Bcvdkerc/VOP-Social-Robot/README.md

# VOP-Social-Robot
All the files necessairy to build a social robot. (Laser cutting + 3d-printing)
