Bcvdkerc/VOP-Social-Robot/sldprt/ONO-modules/Mouth/mouth.sldasm

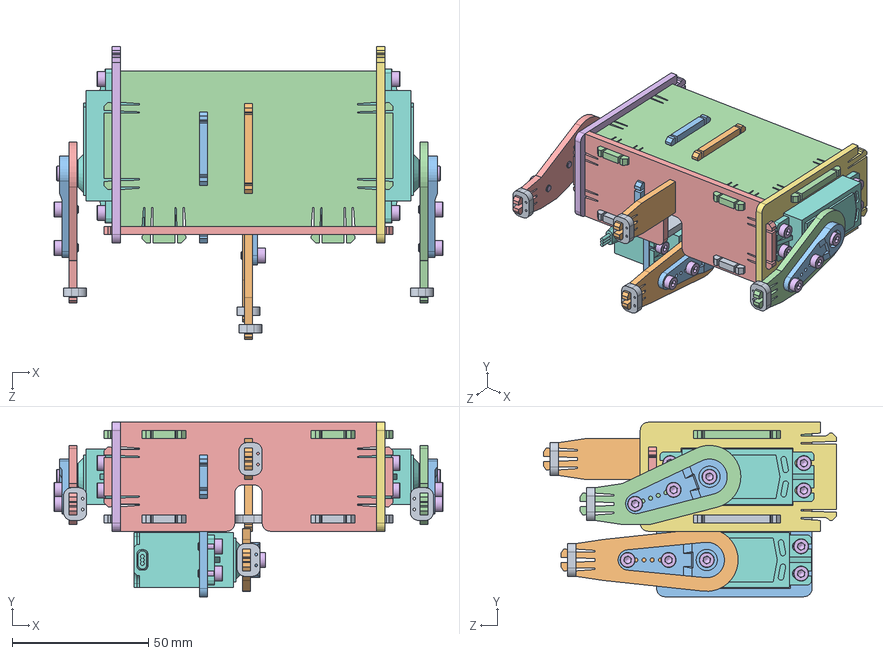
[picture p1: CAD file, 2017-05-16]
sldprt/ONO-modules/Mouth/mouth.sldasm
142.6 x 64.0 x 107.5 mm
mouth-frame-1
mouth-frame-2
mouth-frame-3
mouth-frame-4
mouth-frame-5
mouth-frame-6
mouth-frame-7
servo-standard x 3
textile-snap x 4
lever-mid-towerpro-horn
servo-horn-towerpro-1-arm x 3
lever-outer-l-towerpro-horn
lever-outer-r-towerpro-horn
socket head cap screw_iso x 21
