Bcvdkerc/VOP-Social-Robot/sldprt/ONO-modules/Eyebrow/eyebrow.sldasm

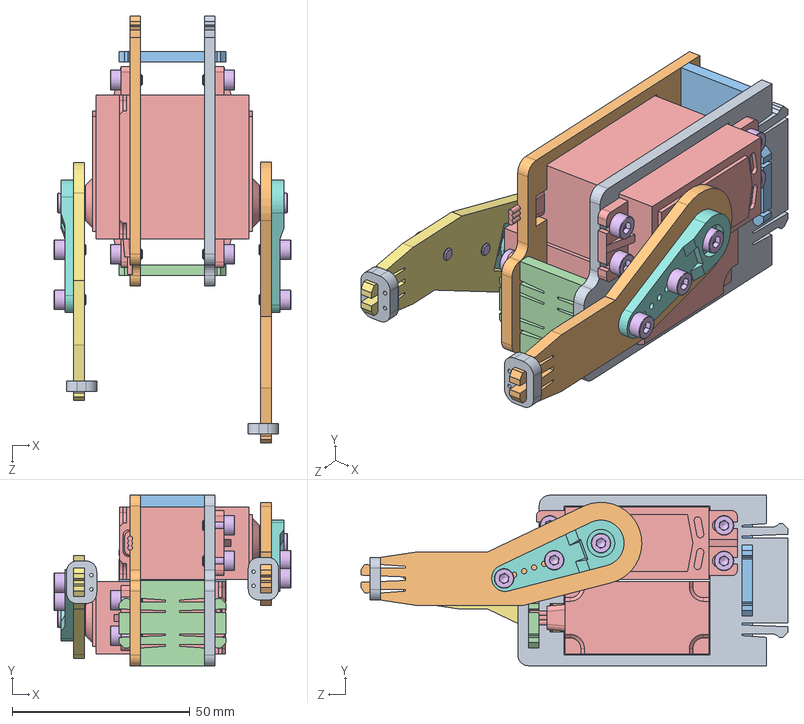
[picture p2: CAD file, 2017-05-16]
sldprt/ONO-modules/Eyebrow/eyebrow.sldasm
66.6 x 48.0 x 120.1 mm
eyebrow-frame-1
eyebrow-frame-2
eyebrow-frame-3
eyebrow-frame-4
servo-standard x 2
socket head cap screw_iso x 14
lever-outer-towerpro-horn
servo-horn-towerpro-1-arm x 2
textile-snap x 2
lever-inner-towerpro-horn
