Bcvdkerc/VOP-Social-Robot/3d-printing/pivot-beam-r.STL

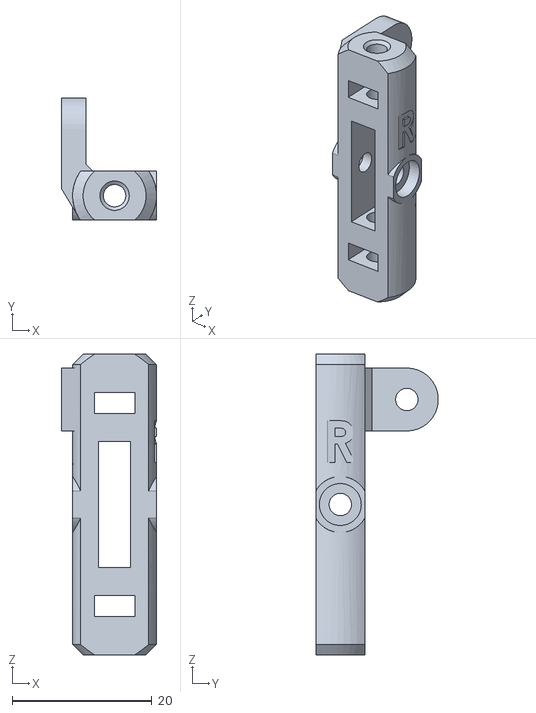
[picture p4: CAD file, 2017-05-16]
3d-printing/pivot-beam-r.STL
13.6 x 17.5 x 43.0
