Bcvdkerc/VOP-Social-Robot/dxf_lasercut/Arms/arms_laser.dxf

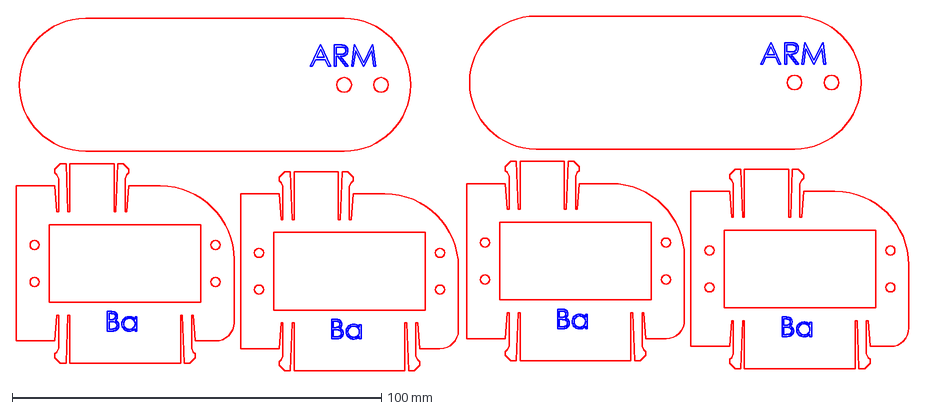
[picture p5: CAD file, 2017-05-16]
dxf_lasercut/Arms/arms_laser.dxf
241.7 x 96.1 mm
