Bcvdkerc/VOP-Social-Robot/dxf_lasercut/Body/b3.DXF

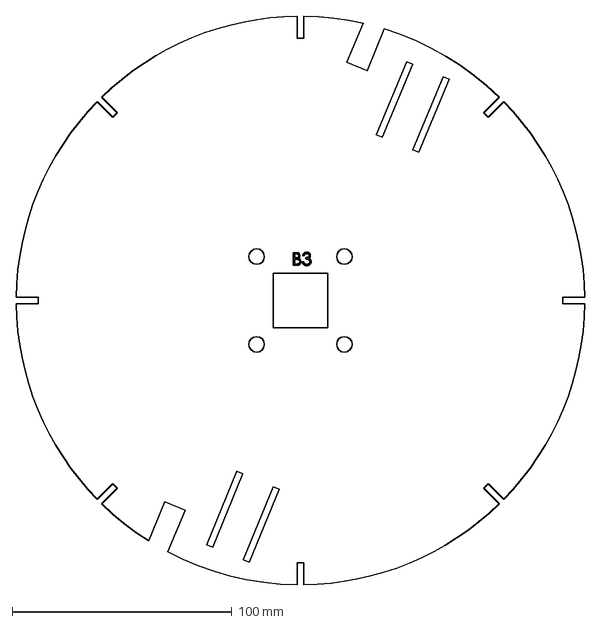
[picture p6: CAD file, 2017-05-16]
dxf_lasercut/Body/b3.DXF
258.8 x 258.8 mm
