Bcvdkerc/VOP-Social-Robot/dxf_lasercut/Box/BOXZ1.DXF

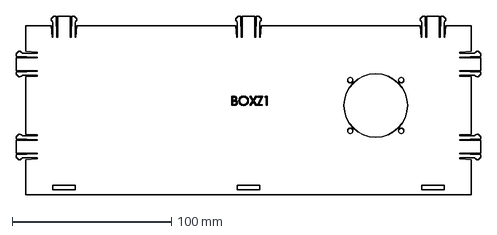
[picture p7: CAD file, 2017-05-16]
dxf_lasercut/Box/BOXZ1.DXF
292.0 x 112.0 mm
