Bcvdkerc/VOP-Social-Robot/dxf_lasercut/Head/HY3a.dxf

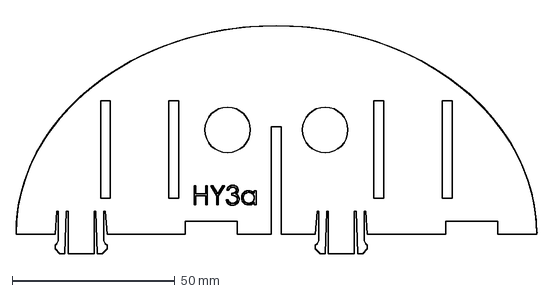
[picture p8: CAD file, 2017-05-16]
dxf_lasercut/Head/HY3a.dxf
160.1 x 72.9 mm
