Bcvdkerc/VOP-Social-Robot/dxf_lasercut/Neck/neck.DXF

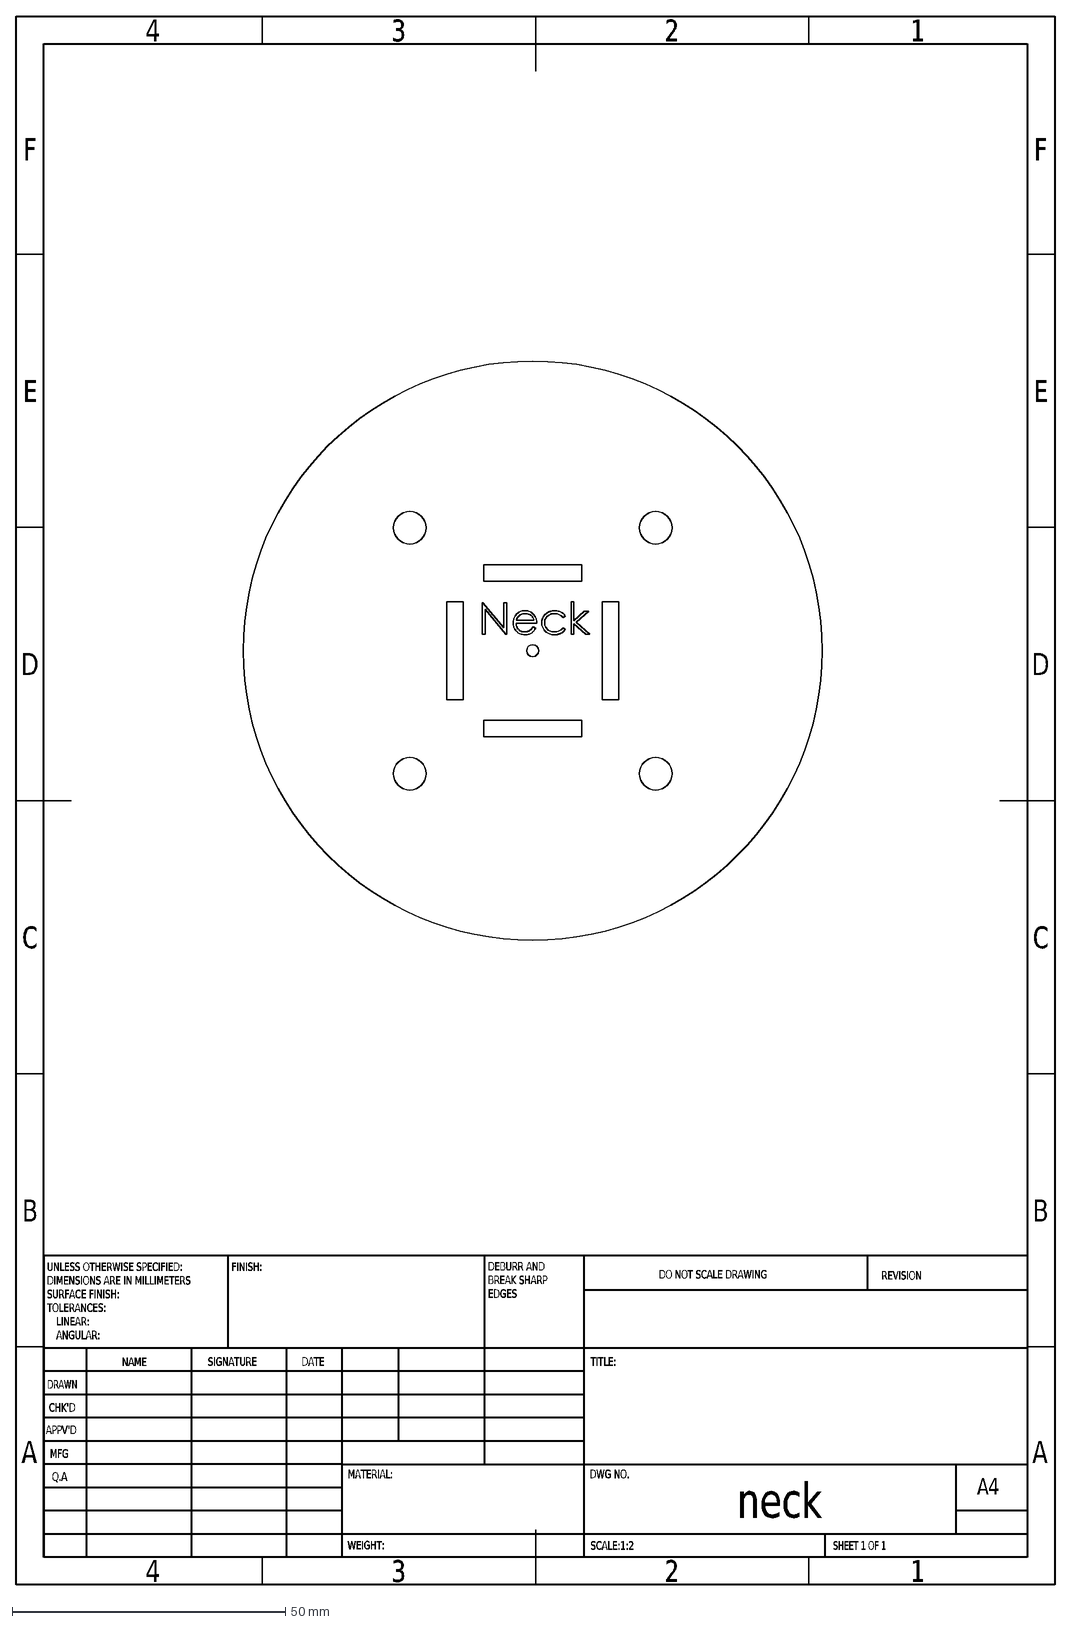
[picture p9: CAD file, 2017-05-16]
dxf_lasercut/Neck/neck.DXF
A
B
C
D
E
F
4
3
2
1
DRAWN
CHK'D
APPV'D
MFG
Q.A
UNLESS OTHERWISE SPECIFIED:
DIMENSIONS ARE IN MILLIMETERS
SURFACE FINISH:
TOLERANCES:
LINEAR:
ANGULAR:
FINISH:
DEBURR AND
BREAK SHARP
EDGES
NAME
SIGNATURE
DATE
MATERIAL:
DO NOT SCALE DRAWING
REVISION
TITLE:
DWG NO.
SCALE:1:2
SHEET 1 OF 1
A4
WEIGHT:
neck
