Bcvdkerc/VOP-Social-Robot/dxf_lasercut/ONO-modules/Eye/eye-laser.dxf

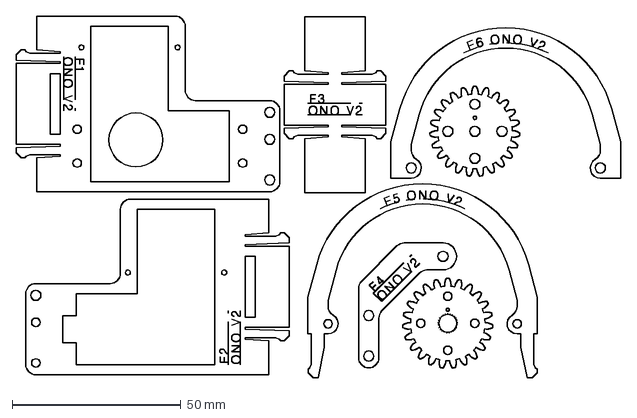
[picture p10: CAD file, 2017-05-16]
dxf_lasercut/ONO-modules/Eye/eye-laser.dxf
178.9 x 107.1 mm
