Bcvdkerc/VOP-Social-Robot/dxf_lasercut/ONO-modules/Eyebrow/eyebrow-laser.dxf

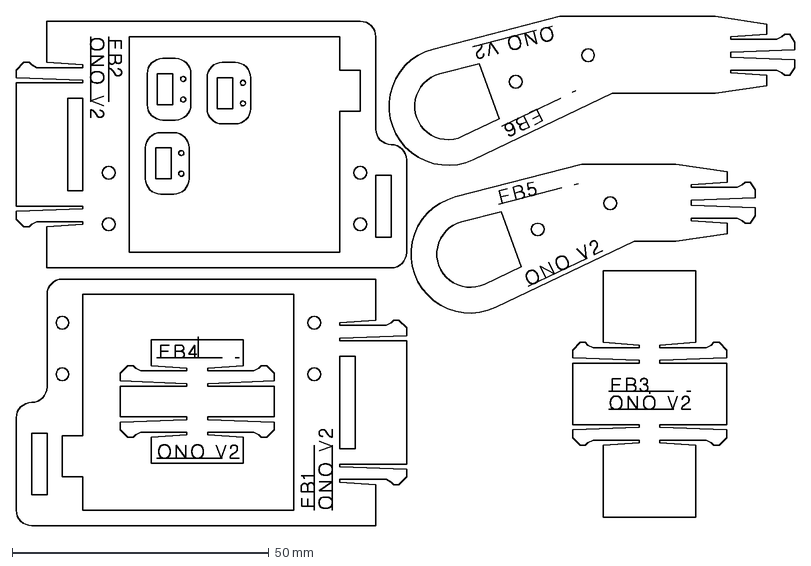
[picture p11: CAD file, 2017-05-16]
dxf_lasercut/ONO-modules/Eyebrow/eyebrow-laser.dxf
151.6 x 99.1 mm
