Bcvdkerc/VOP-Social-Robot/dxf_lasercut/ONO-modules/Mouth/mouth-laser.dxf

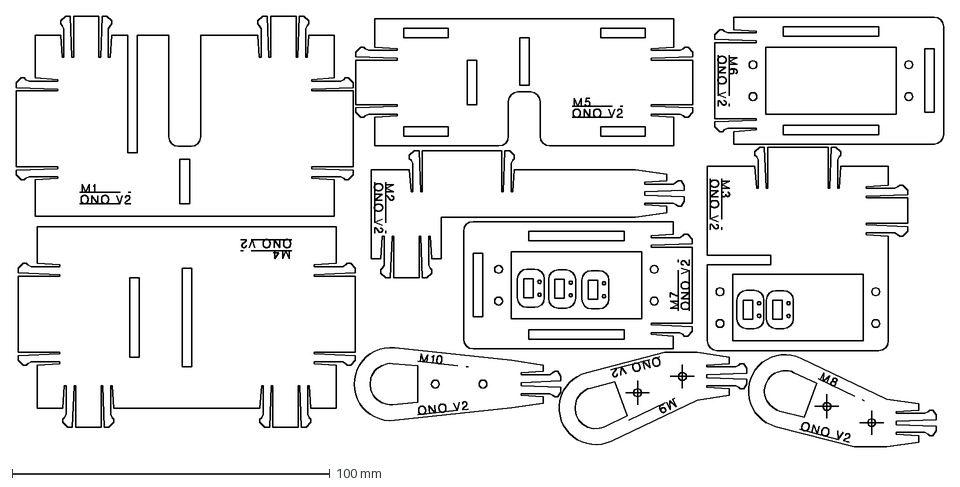
[picture p12: CAD file, 2017-05-16]
dxf_lasercut/ONO-modules/Mouth/mouth-laser.dxf
291.8 x 135.6 mm
