Bcvdkerc/VOP-Social-Robot/sldprt/Arms/Ba.SLDPRT

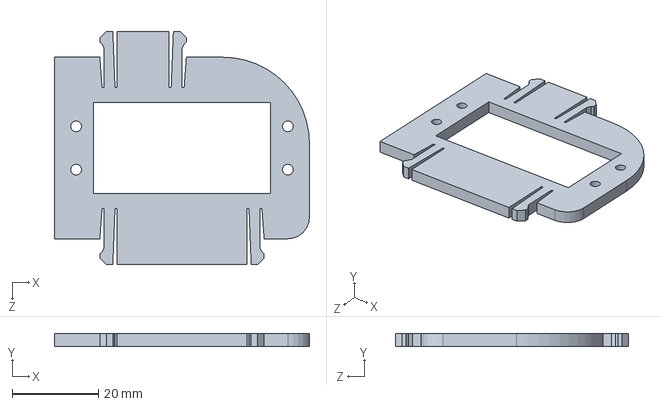
[picture p13: CAD file, 2017-05-16]
sldprt/Arms/Ba.SLDPRT
59.0 x 3.00 x 54.0 mm
