Bcvdkerc/VOP-Social-Robot/sldprt/Body/b2.SLDPRT

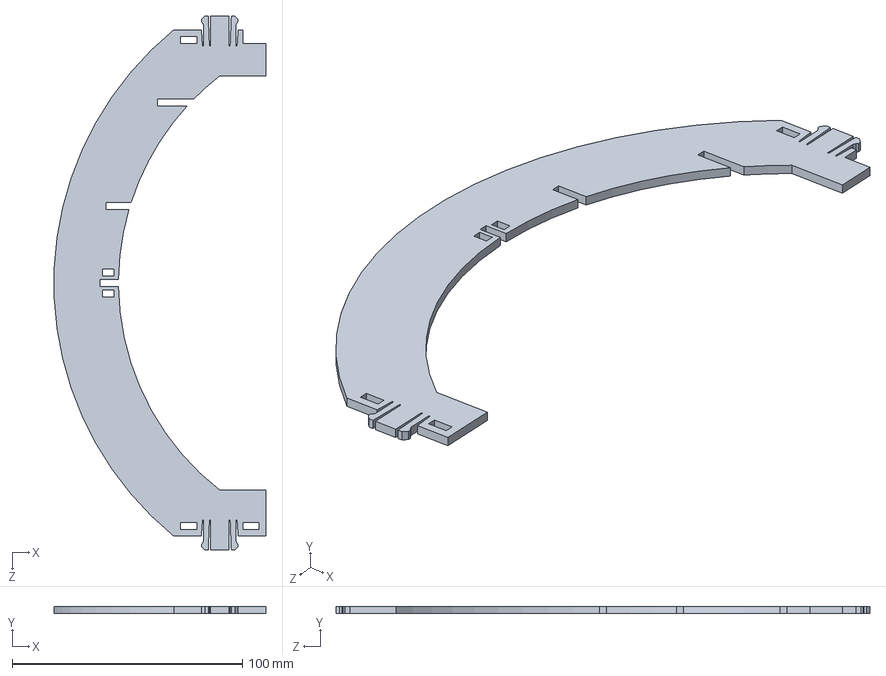
[picture p14: CAD file, 2017-05-16]
sldprt/Body/b2.SLDPRT
92.0 x 3.00 x 232.0 mm
