Bcvdkerc/VOP-Social-Robot/sldprt/Box/BOXX2.SLDPRT

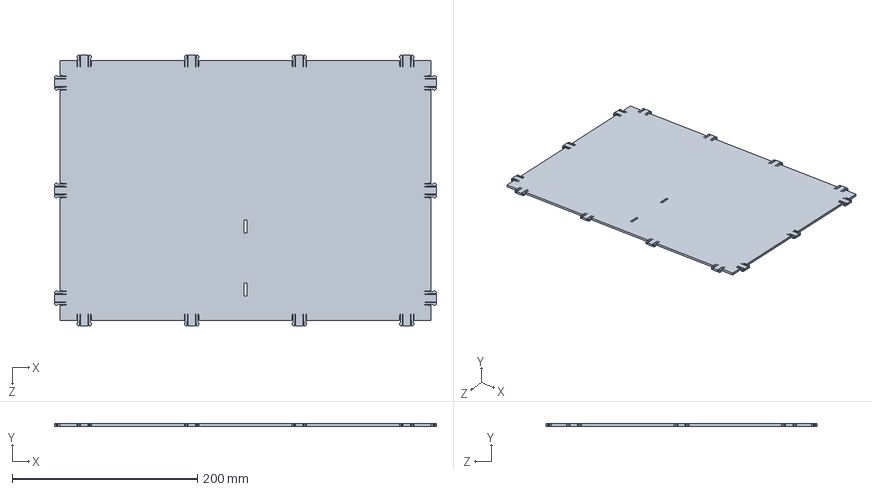
[picture p15: CAD file, 2017-05-16]
sldprt/Box/BOXX2.SLDPRT
412.0 x 3.00 x 292.0 mm
