Bcvdkerc/VOP-Social-Robot/sldprt/Head/HX1.SLDPRT

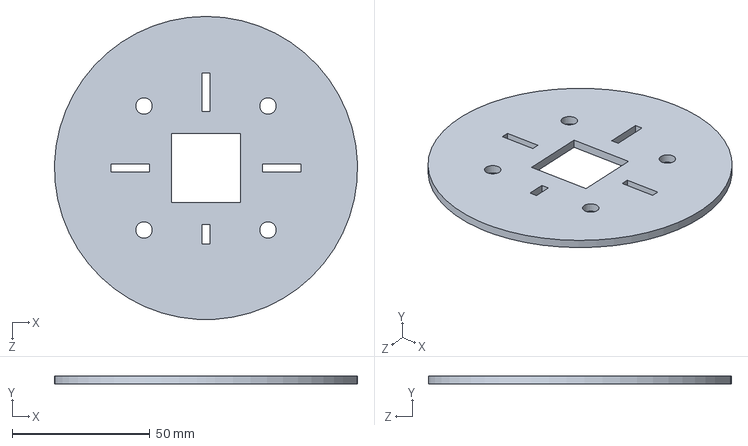
[picture p16: CAD file, 2017-05-16]
sldprt/Head/HX1.SLDPRT
110.0 x 3.00 x 110.0 mm
