Bcvdkerc/VOP-Social-Robot/sldprt/ONO-modules/Eye/eyelid.SLDPRT

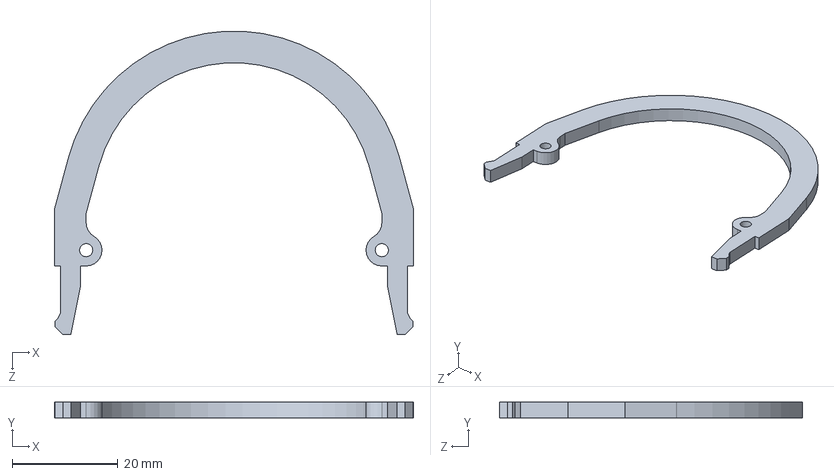
[picture p17: CAD file, 2017-05-16]
sldprt/ONO-modules/Eye/eyelid.SLDPRT
68.0 x 3.00 x 57.4 mm
