Bcvdkerc/VOP-Social-Robot/sldprt/ONO-modules/Eyebrow/lever-outer-towerpro-horn.SLDPRT

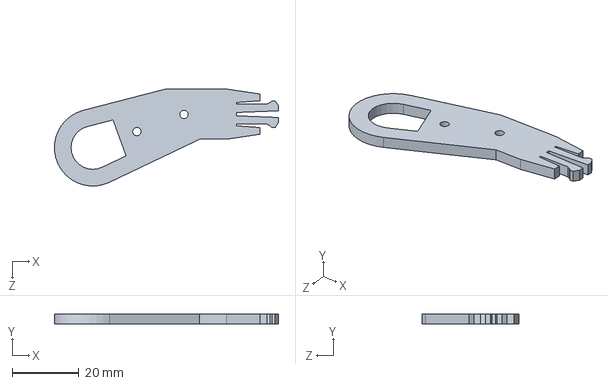
[picture p18: CAD file, 2017-05-16]
sldprt/ONO-modules/Eyebrow/lever-outer-towerpro-horn.SLDPRT
67.0 x 3.00 x 29.0 mm
