Bcvdkerc/VOP-Social-Robot/dxf_lasercut/Arms/Ba.DXF

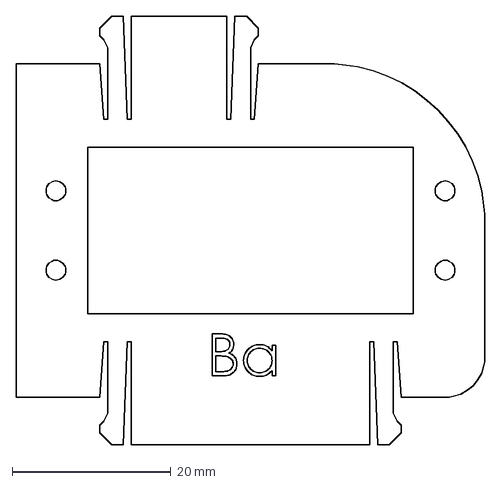
[picture p19: CAD file, 2017-05-16]
dxf_lasercut/Arms/Ba.DXF
59.0 x 54.0 mm
