Bcvdkerc/VOP-Social-Robot/dxf_lasercut/Body/b6.DXF

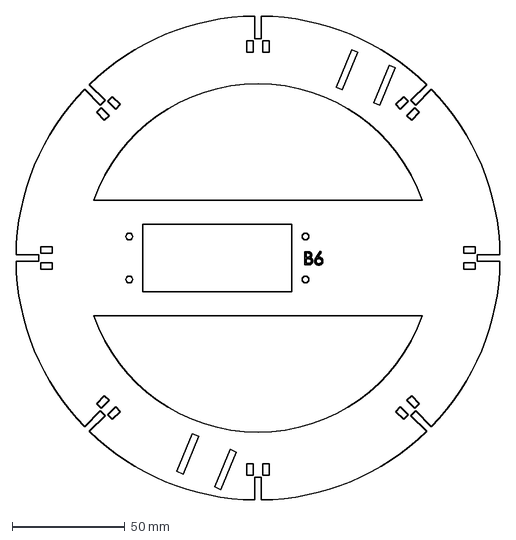
[picture p20: CAD file, 2017-05-16]
dxf_lasercut/Body/b6.DXF
214.2 x 214.2 mm
