Bcvdkerc/VOP-Social-Robot/dxf_lasercut/Head/HZ3.DXF

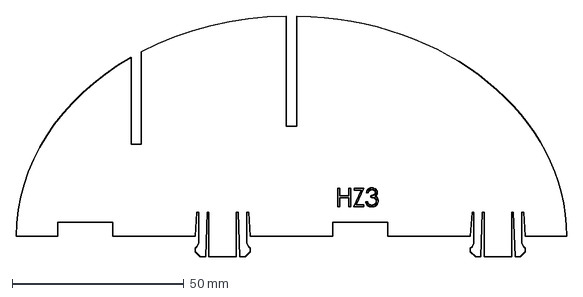
[picture p21: CAD file, 2017-05-16]
dxf_lasercut/Head/HZ3.DXF
160.0 x 70.0 mm
