Bcvdkerc/VOP-Social-Robot/dxf_lasercut/Neck/neck_laser.dxf

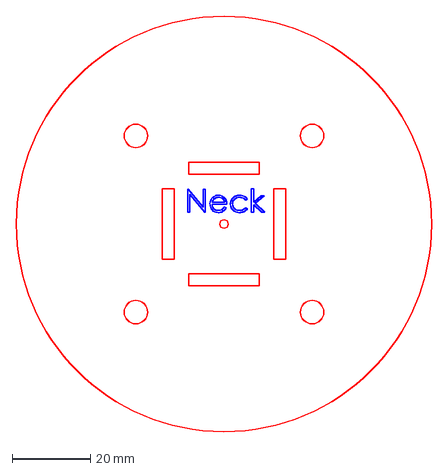
[picture p22: CAD file, 2017-05-16]
dxf_lasercut/Neck/neck_laser.dxf
106.0 x 106.0 mm
