Bcvdkerc/VOP-Social-Robot/sldprt/Arms/arm.SLDPRT

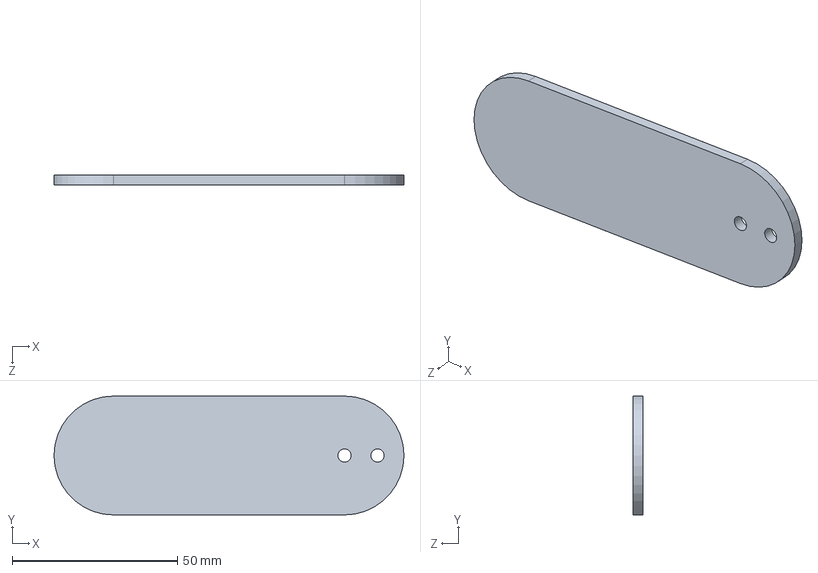
[picture p23: CAD file, 2017-05-16]
sldprt/Arms/arm.SLDPRT
106.0 x 36.0 x 3.00 mm
