Bcvdkerc/VOP-Social-Robot/sldprt/Body/b1.SLDPRT

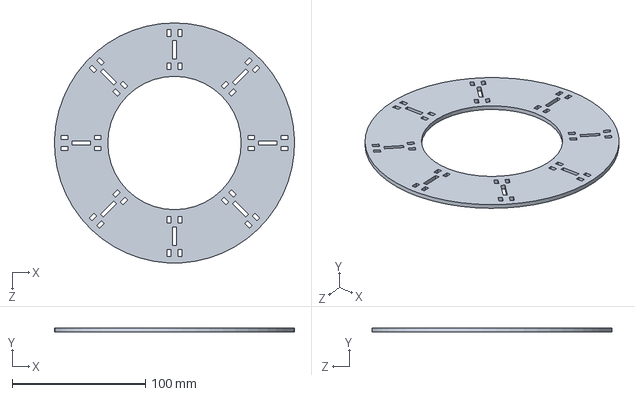
[picture p24: CAD file, 2017-05-16]
sldprt/Body/b1.SLDPRT
179.9 x 3.00 x 180.0 mm
