Bcvdkerc/VOP-Social-Robot/sldprt/Box/BOXZ1.SLDPRT

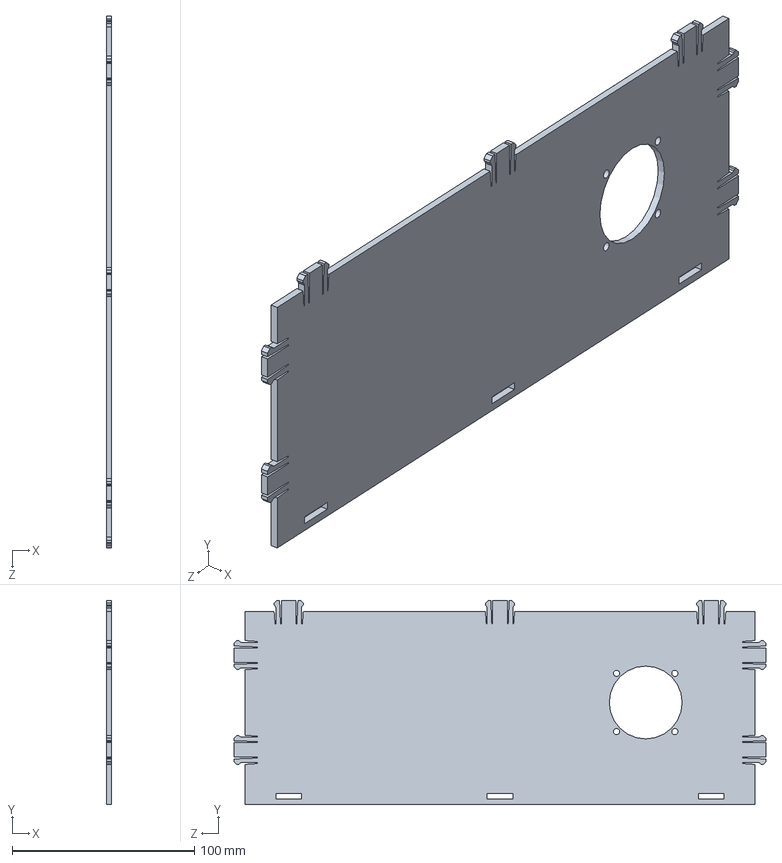
[picture p25: CAD file, 2017-05-16]
sldprt/Box/BOXZ1.SLDPRT
3.00 x 112.0 x 292.0 mm
