Bcvdkerc/VOP-Social-Robot/sldprt/Head/HY3b.SLDPRT

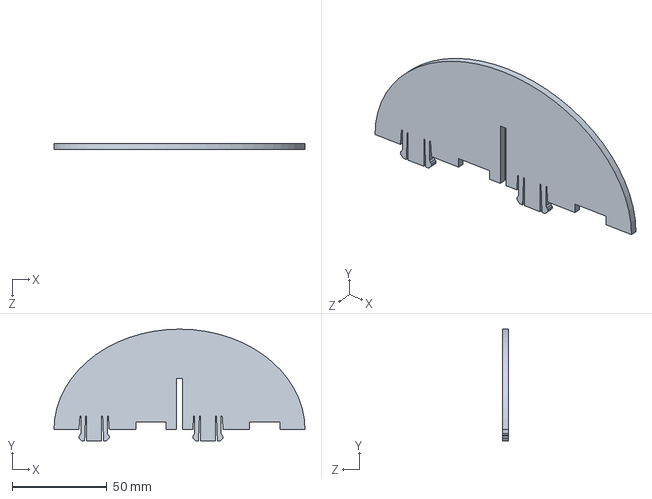
[picture p26: CAD file, 2017-05-16]
sldprt/Head/HY3b.SLDPRT
132.3 x 58.9 x 3.00 mm
