Bcvdkerc/VOP-Social-Robot/sldprt/ONO-modules/Eye/eye-frame-spacer.SLDPRT

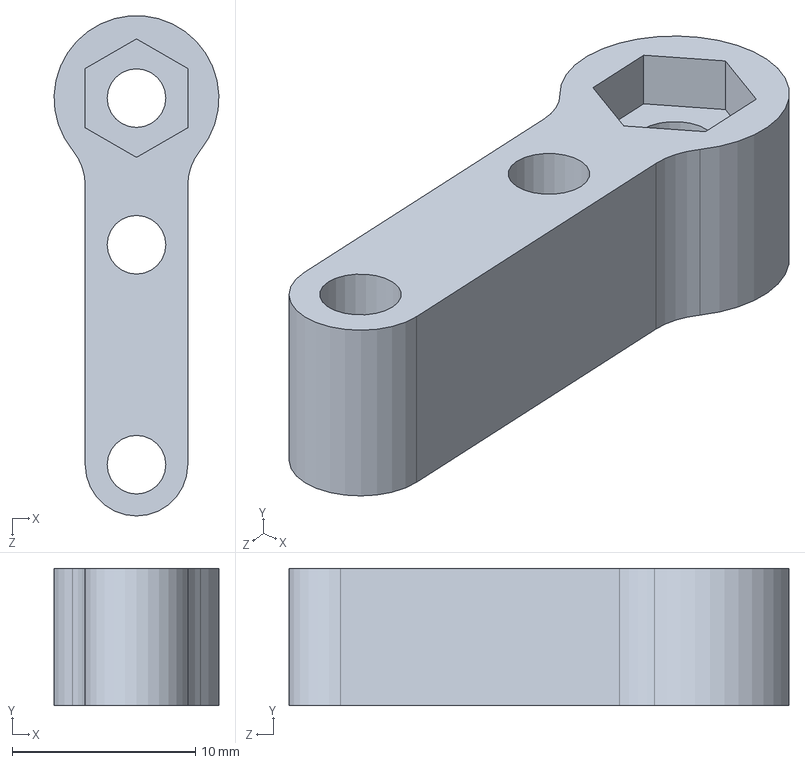
[picture p27: CAD file, 2017-05-16]
sldprt/ONO-modules/Eye/eye-frame-spacer.SLDPRT
8.99 x 7.50 x 27.3 mm
