Bcvdkerc/VOP-Social-Robot/sldprt/ONO-modules/Eyebrow/eyebrow-frame-4.sldprt

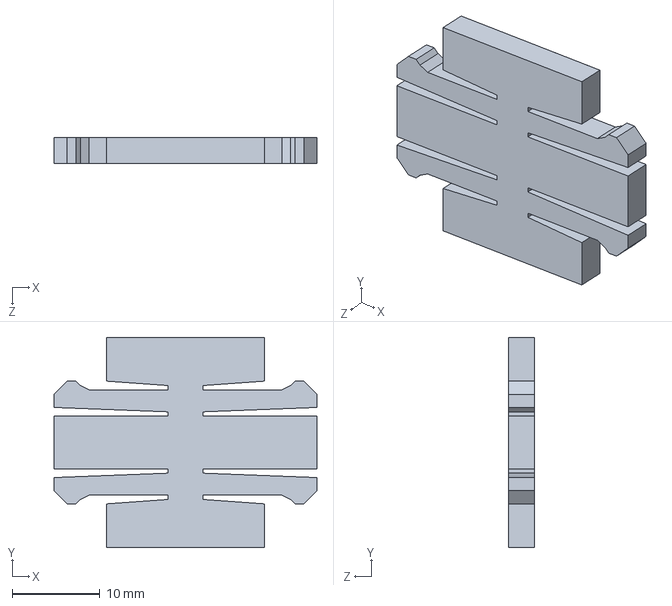
[picture p28: CAD file, 2017-05-16]
sldprt/ONO-modules/Eyebrow/eyebrow-frame-4.sldprt
30.0 x 24.0 x 3.00 mm
