Bcvdkerc/VOP-Social-Robot/3d-printing/eye-shell-l.STL

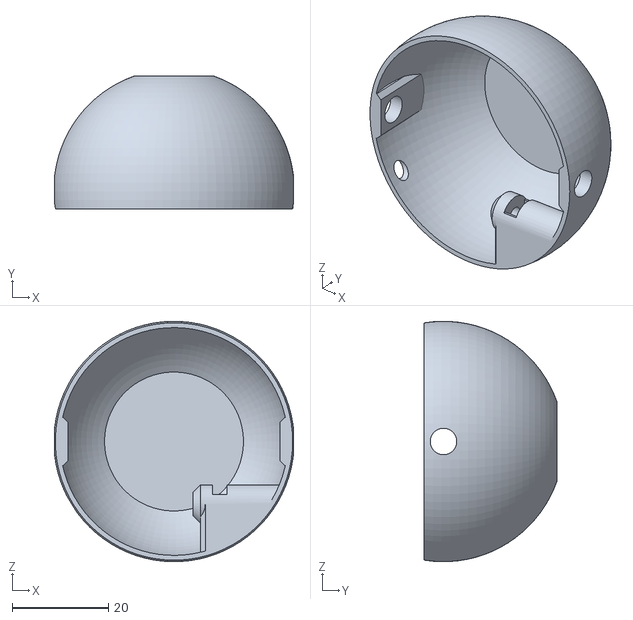
[picture p29: CAD file, 2017-05-16]
3d-printing/eye-shell-l.STL
49.7 x 27.6 x 50.0
