Bcvdkerc/VOP-Social-Robot/dxf_lasercut/Arms/arm.DXF

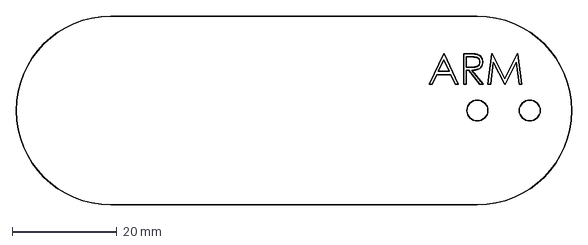
[picture p30: CAD file, 2017-05-16]
dxf_lasercut/Arms/arm.DXF
106.0 x 36.0 mm
