Bcvdkerc/VOP-Social-Robot/dxf_lasercut/Body/b1.DXF

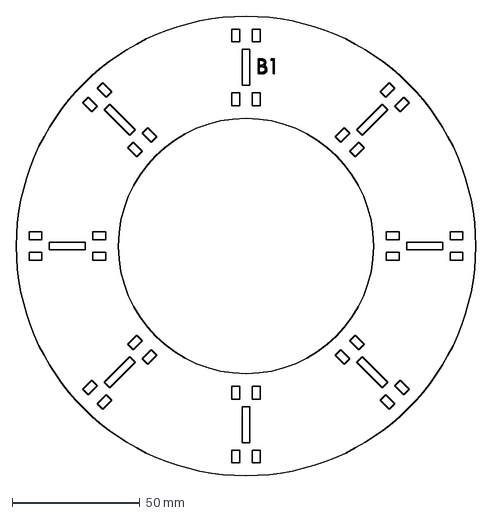
[picture p31: CAD file, 2017-05-16]
dxf_lasercut/Body/b1.DXF
180.0 x 180.0 mm
