Bcvdkerc/VOP-Social-Robot/dxf_lasercut/Head/head_laser.dxf

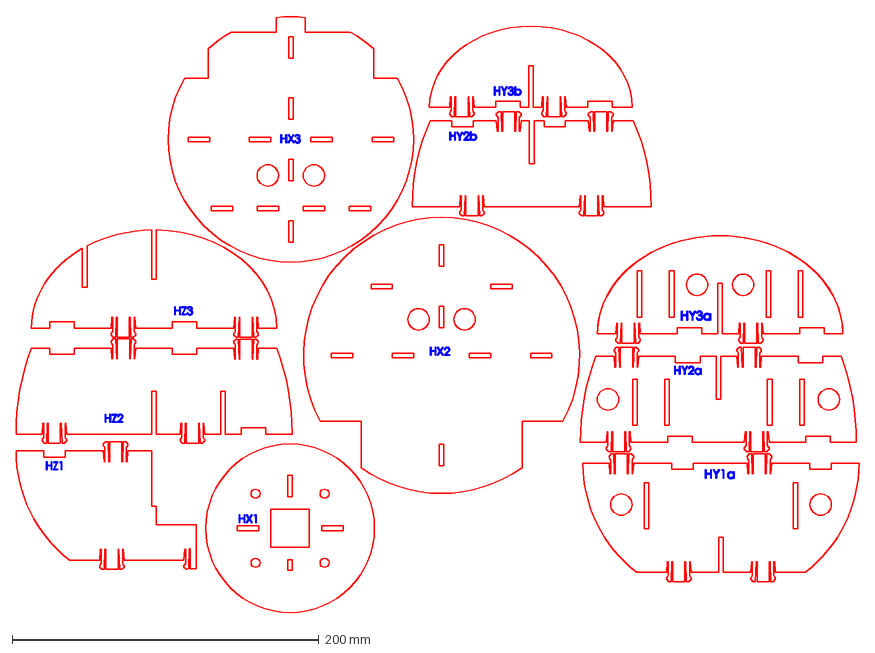
[picture p32: CAD file, 2017-05-16]
dxf_lasercut/Head/head_laser.dxf
549.6 x 388.7 mm
