Bcvdkerc/VOP-Social-Robot/sldprt/Body/b5.SLDPRT

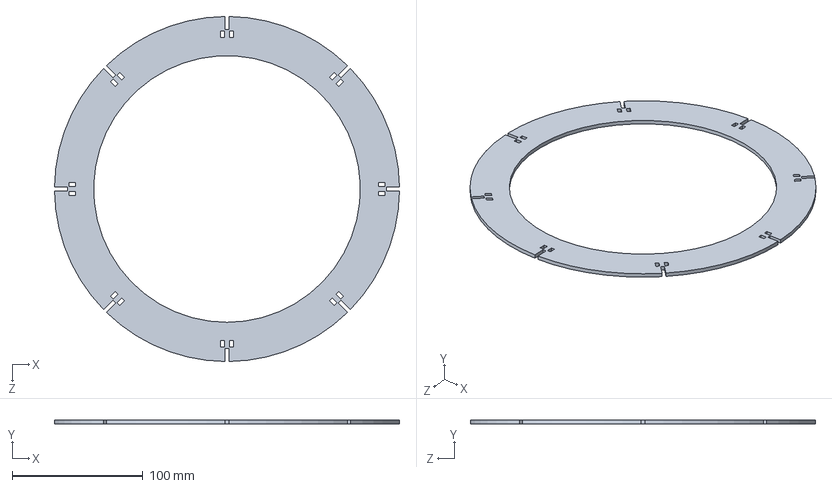
[picture p33: CAD file, 2017-05-16]
sldprt/Body/b5.SLDPRT
264.0 x 3.00 x 264.0 mm
