Bcvdkerc/VOP-Social-Robot/sldprt/Head/HZ1.SLDPRT

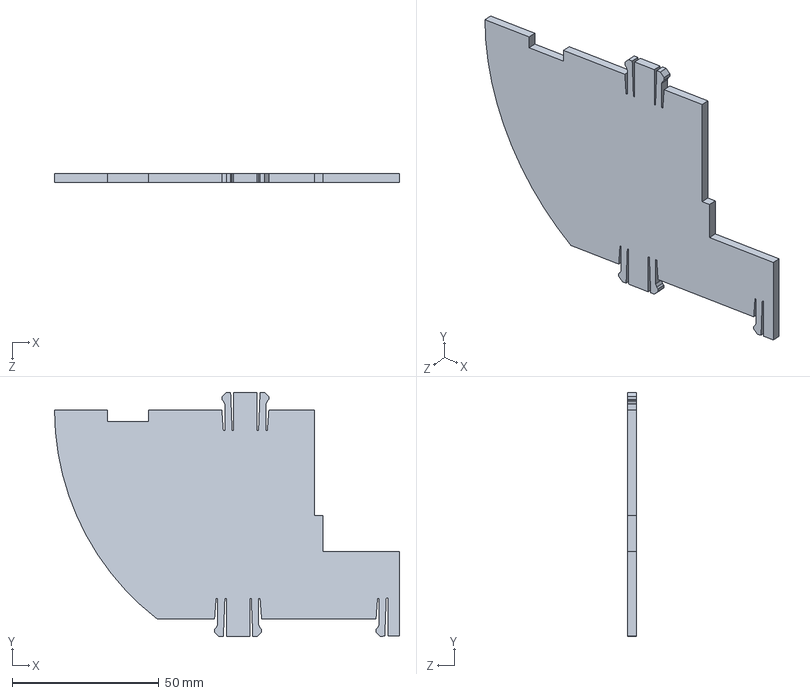
[picture p34: CAD file, 2017-05-16]
sldprt/Head/HZ1.SLDPRT
117.5 x 83.2 x 3.00 mm
