Bcvdkerc/VOP-Social-Robot/sldprt/ONO-modules/Eyebrow/lever-outer-printed-horn.SLDPRT

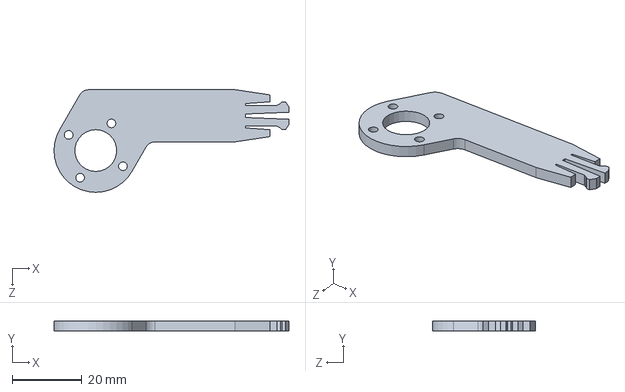
[picture p35: CAD file, 2017-05-16]
sldprt/ONO-modules/Eyebrow/lever-outer-printed-horn.SLDPRT
67.5 x 3.00 x 29.5 mm
