Bcvdkerc/VOP-Social-Robot/sldprt/ONO-modules/Mouth/lever-outer-l-printed-horn.SLDPRT

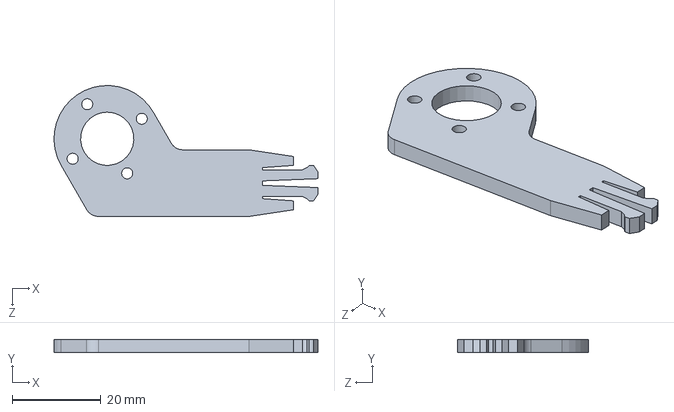
[picture p36: CAD file, 2017-05-16]
sldprt/ONO-modules/Mouth/lever-outer-l-printed-horn.SLDPRT
59.5 x 3.00 x 29.5 mm
