Bcvdkerc/VOP-Social-Robot/3d-printing/eyelid-idler-r.STL

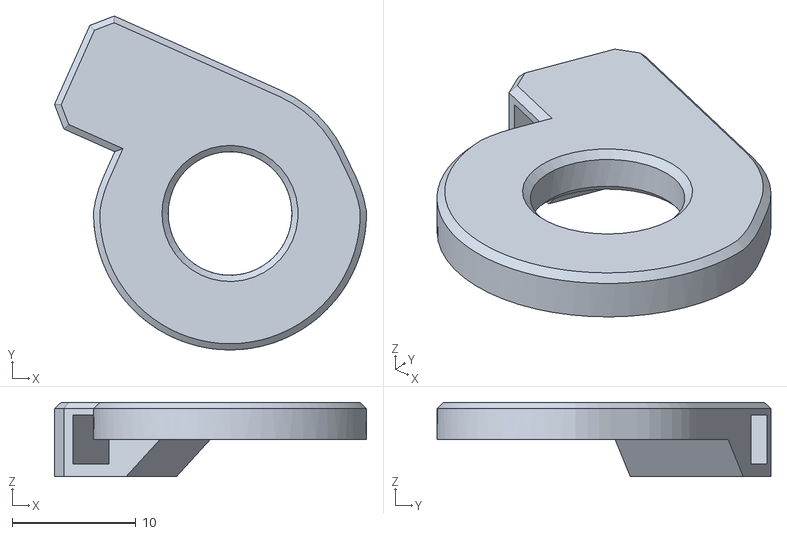
[picture p37: CAD file, 2017-05-16]
3d-printing/eyelid-idler-r.STL
25.2 x 27.0 x 6.00
