Bcvdkerc/VOP-Social-Robot/dxf_lasercut/Body/body_laser.dxf

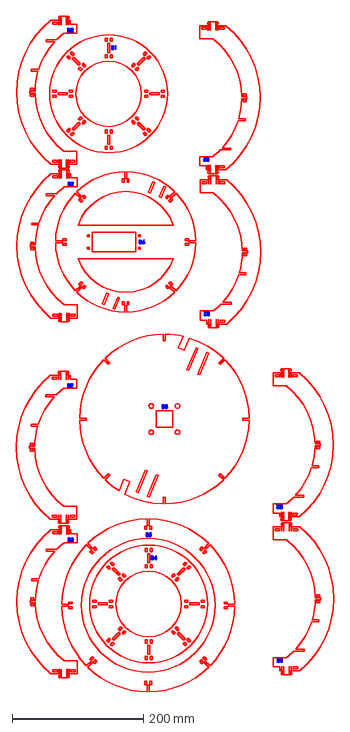
[picture p38: CAD file, 2017-05-16]
dxf_lasercut/Body/body_laser.dxf
484.6 x 1031.3 mm
