Bcvdkerc/VOP-Social-Robot/dxf_lasercut/Head/HX2.DXF

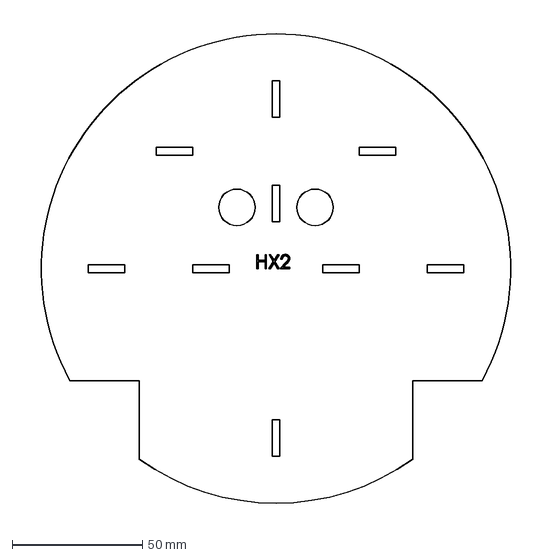
[picture p39: CAD file, 2017-05-16]
dxf_lasercut/Head/HX2.DXF
199.3 x 192.5 mm
