Bcvdkerc/VOP-Social-Robot/sldprt/Body/b6.SLDPRT

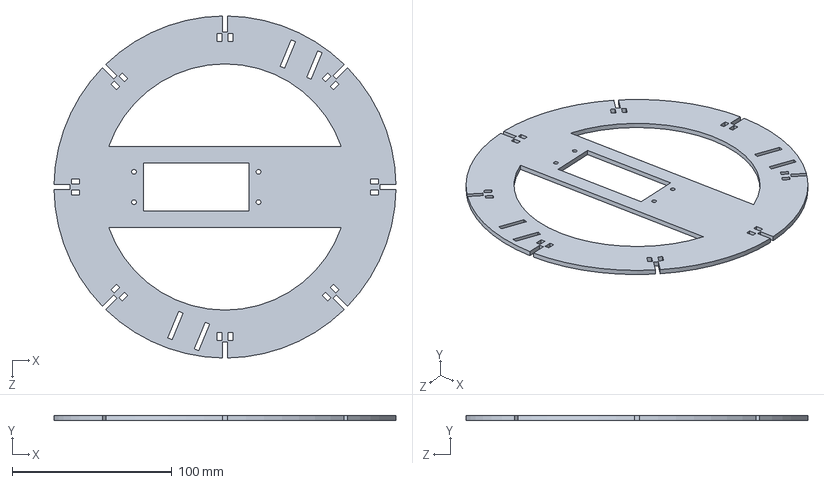
[picture p40: CAD file, 2017-05-16]
sldprt/Body/b6.SLDPRT
214.2 x 3.00 x 214.2 mm
