Bcvdkerc/VOP-Social-Robot/sldprt/Box/stability.SLDPRT

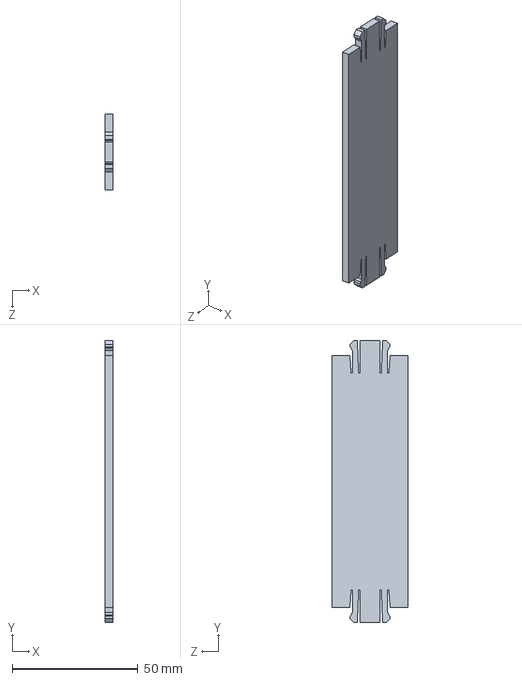
[picture p41: CAD file, 2017-05-16]
sldprt/Box/stability.SLDPRT
3.00 x 112.0 x 30.0 mm
