Bcvdkerc/VOP-Social-Robot/sldprt/Head/HX3.SLDPRT

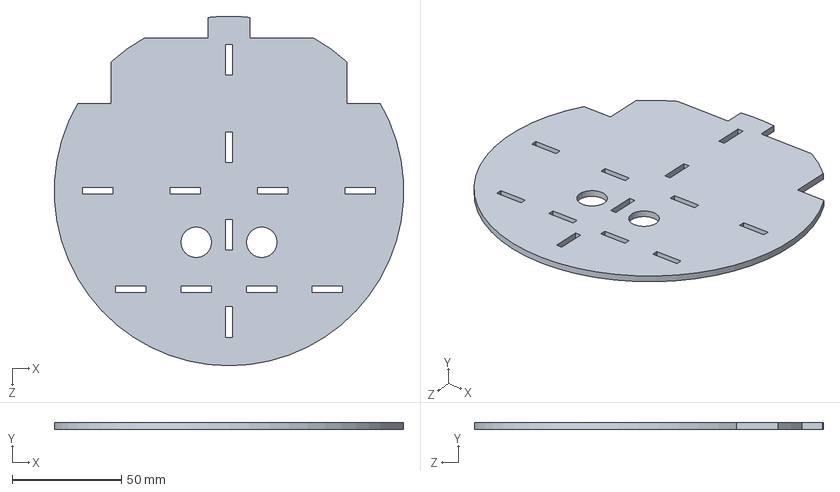
[picture p42: CAD file, 2017-05-16]
sldprt/Head/HX3.SLDPRT
159.7 x 3.00 x 159.9 mm
