Bcvdkerc/VOP-Social-Robot/sldprt/ONO-modules/Eyebrow/lever-inner-towerpro-horn.SLDPRT

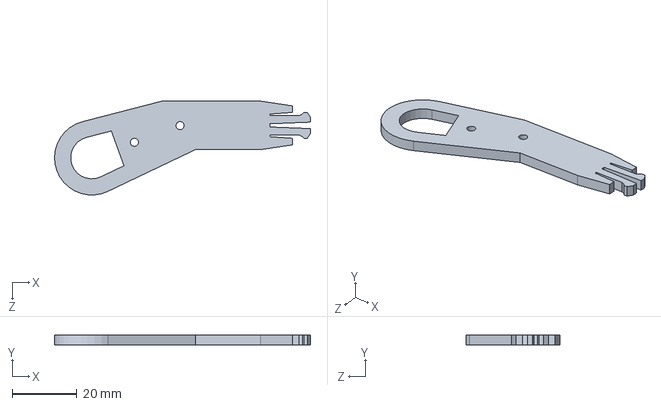
[picture p43: CAD file, 2017-05-16]
sldprt/ONO-modules/Eyebrow/lever-inner-towerpro-horn.SLDPRT
79.0 x 3.00 x 29.0 mm
