Bcvdkerc/VOP-Social-Robot/3d-printing/eyelid-gear-l.STL

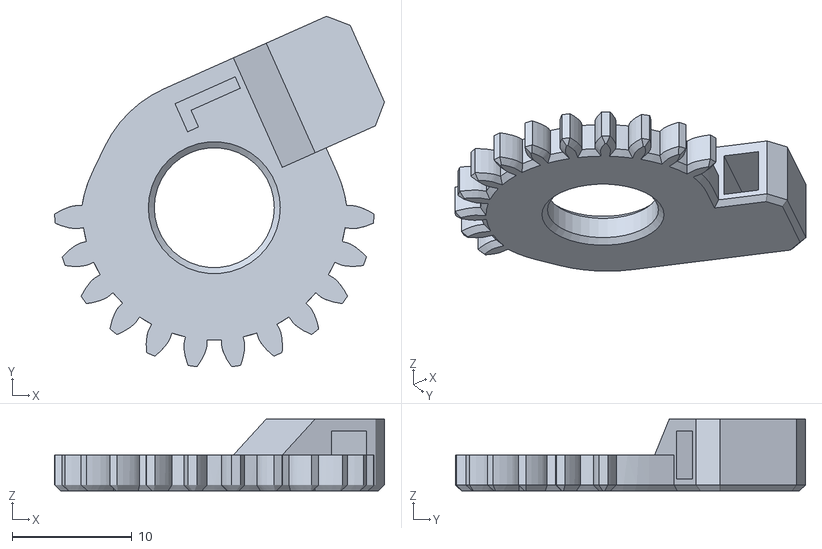
[picture p44: CAD file, 2017-05-16]
3d-printing/eyelid-gear-l.STL
27.5 x 29.2 x 6.00
