Bcvdkerc/VOP-Social-Robot/dxf_lasercut/Body/b4.DXF

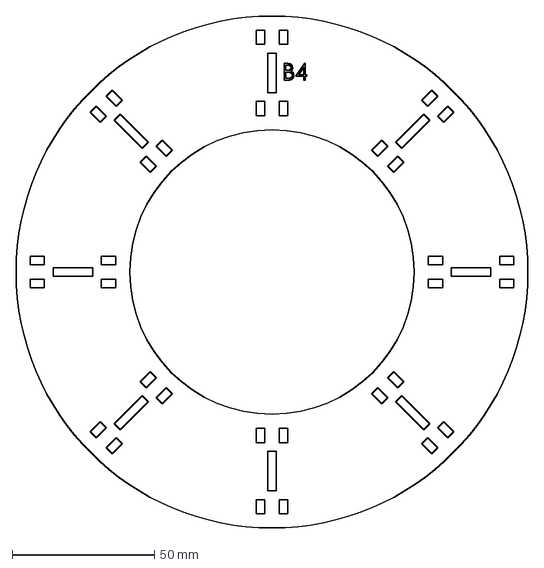
[picture p45: CAD file, 2017-05-16]
dxf_lasercut/Body/b4.DXF
180.0 x 180.0 mm
