Bcvdkerc/VOP-Social-Robot/dxf_lasercut/Box/BOXZ2.DXF

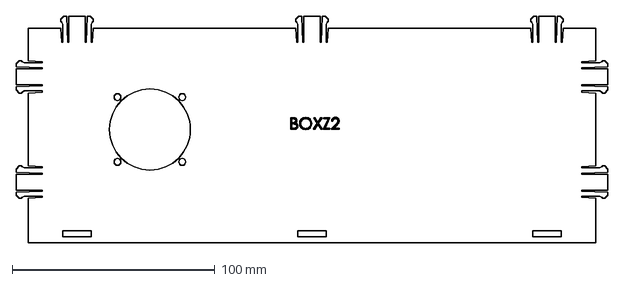
[picture p46: CAD file, 2017-05-16]
dxf_lasercut/Box/BOXZ2.DXF
292.0 x 112.0 mm
