Bcvdkerc/VOP-Social-Robot/dxf_lasercut/Head/HX1.DXF

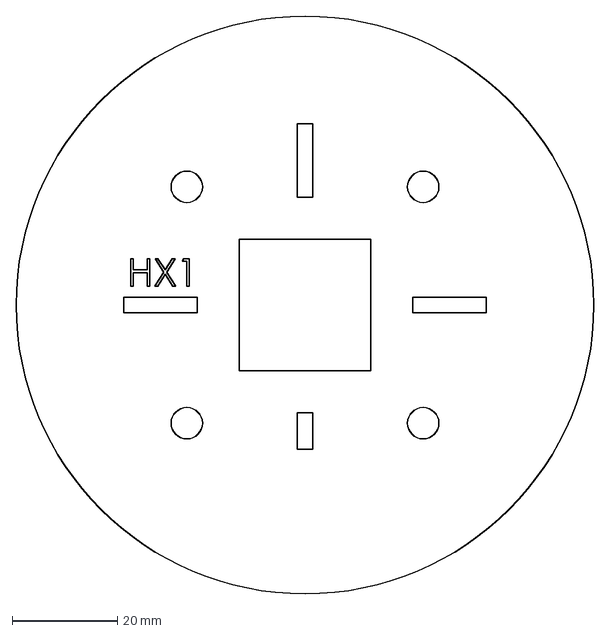
[picture p47: CAD file, 2017-05-16]
dxf_lasercut/Head/HX1.DXF
110.0 x 110.0 mm
