Bcvdkerc/VOP-Social-Robot/sldprt/Body/b3.SLDPRT

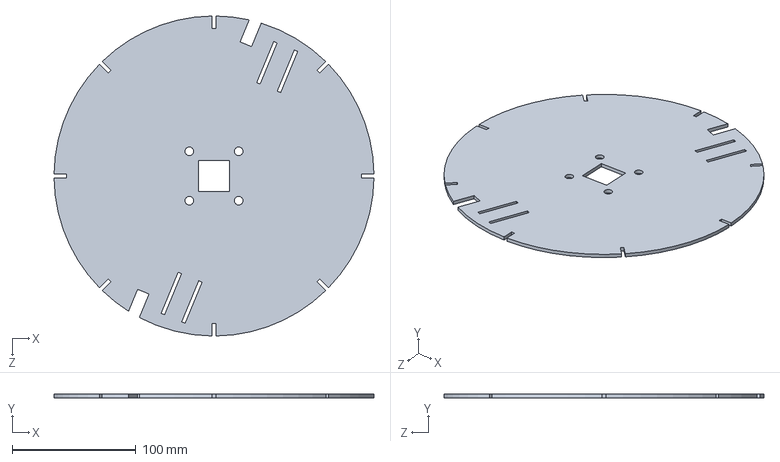
[picture p48: CAD file, 2017-05-16]
sldprt/Body/b3.SLDPRT
258.8 x 3.00 x 258.8 mm
