Bcvdkerc/VOP-Social-Robot/sldprt/Box/BOXX1.SLDPRT

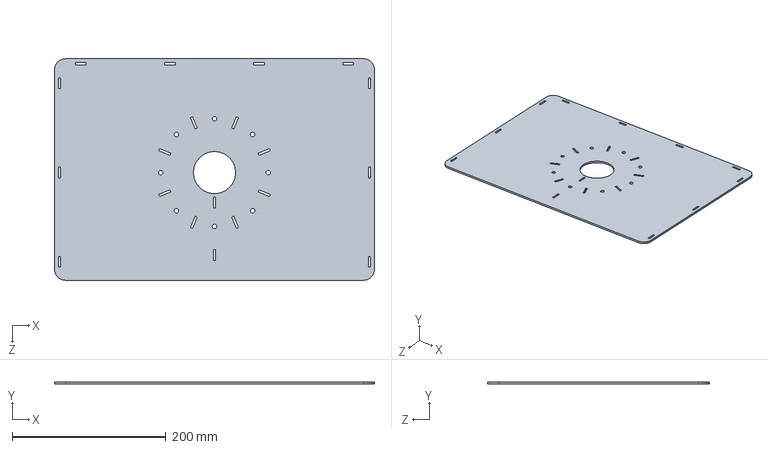
[picture p49: CAD file, 2017-05-16]
sldprt/Box/BOXX1.SLDPRT
416.0 x 3.00 x 288.0 mm
