Bcvdkerc/VOP-Social-Robot/sldprt/Head/HZ2.SLDPRT

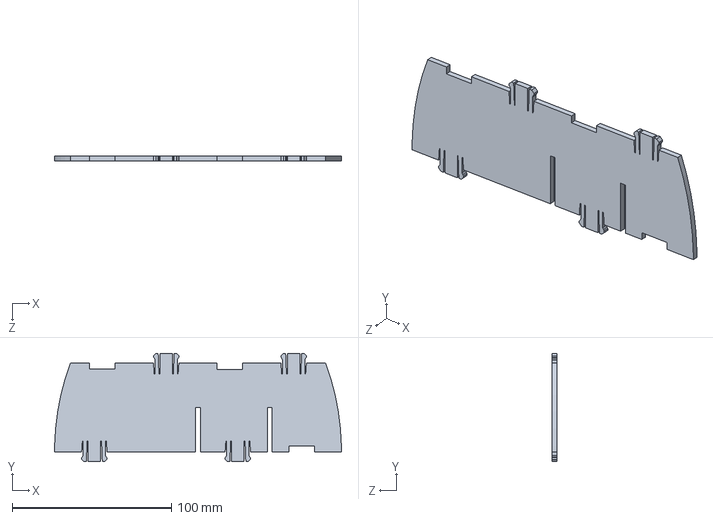
[picture p50: CAD file, 2017-05-16]
sldprt/Head/HZ2.SLDPRT
180.0 x 68.0 x 3.00 mm
