Bcvdkerc/VOP-Social-Robot/sldprt/ONO-modules/Eyebrow/eyebrow-frame-3.sldprt

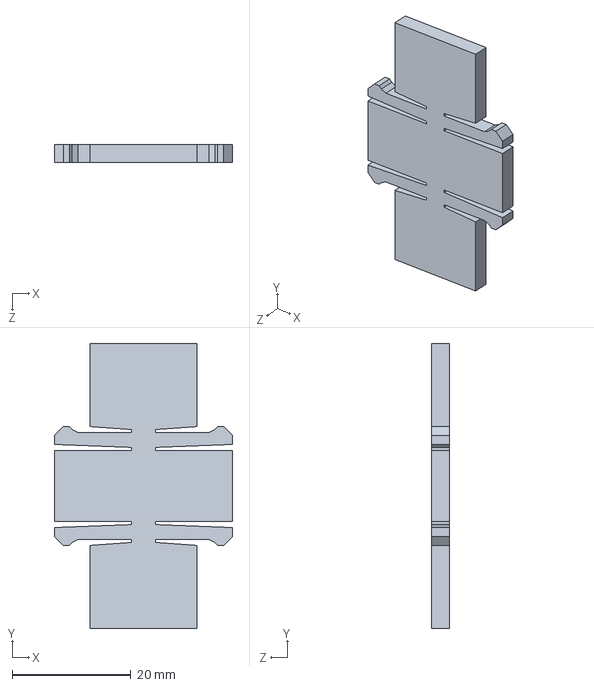
[picture p51: CAD file, 2017-05-16]
sldprt/ONO-modules/Eyebrow/eyebrow-frame-3.sldprt
30.0 x 48.0 x 3.00 mm
