Bcvdkerc/VOP-Social-Robot/sldprt/ONO-modules/Mouth/lever-outer-r-towerpro-horn.SLDPRT

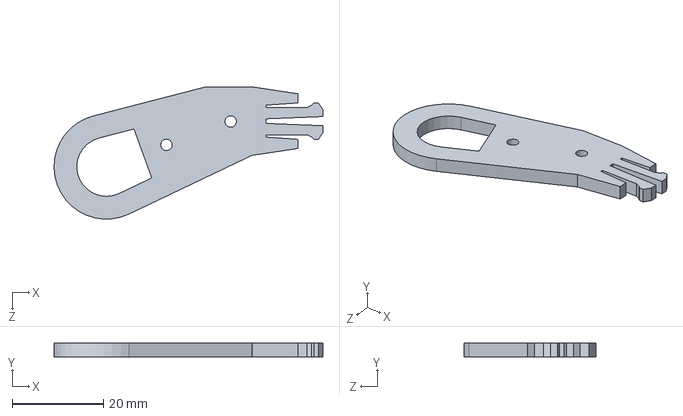
[picture p52: CAD file, 2017-05-16]
sldprt/ONO-modules/Mouth/lever-outer-r-towerpro-horn.SLDPRT
59.0 x 3.00 x 29.0 mm
