Bcvdkerc/VOP-Social-Robot/dxf_lasercut/Body/b2.DXF

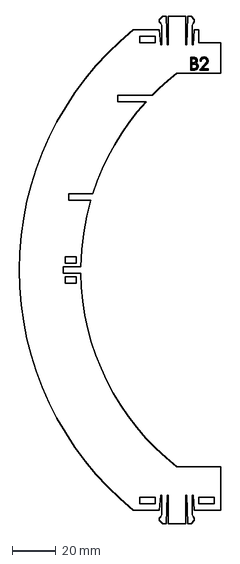
[picture p53: CAD file, 2017-05-16]
dxf_lasercut/Body/b2.DXF
92.1 x 232.0 mm
