Bcvdkerc/VOP-Social-Robot/dxf_lasercut/Head/HY3b.DXF

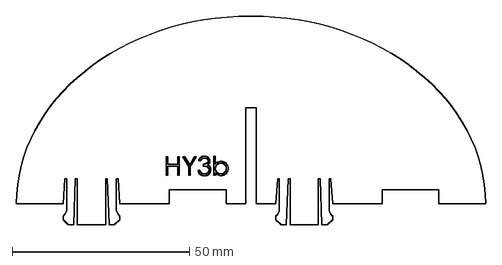
[picture p54: CAD file, 2017-05-16]
dxf_lasercut/Head/HY3b.DXF
132.3 x 58.9 mm
