Bcvdkerc/VOP-Social-Robot/sldprt/Box/BOXY2.SLDPRT

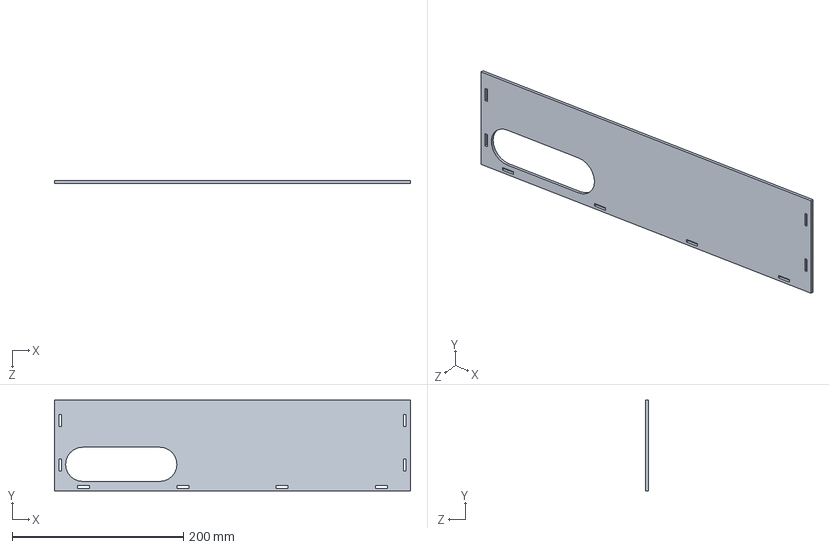
[picture p55: CAD file, 2017-05-16]
sldprt/Box/BOXY2.SLDPRT
416.0 x 106.0 x 3.00 mm
