Bcvdkerc/VOP-Social-Robot/sldprt/Head/HX2.SLDPRT

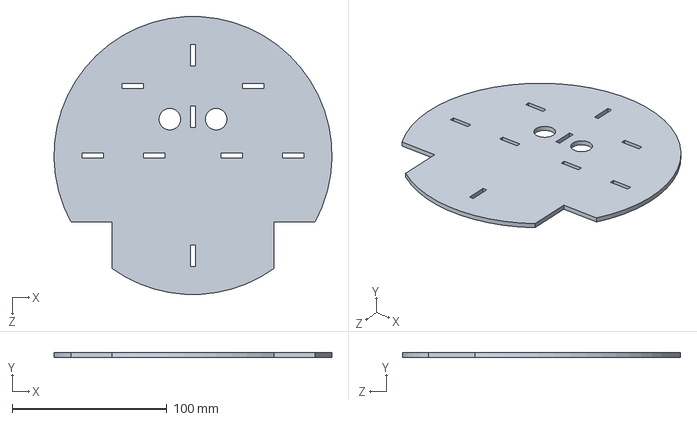
[picture p56: CAD file, 2017-05-16]
sldprt/Head/HX2.SLDPRT
179.9 x 3.00 x 179.7 mm
