Bcvdkerc/VOP-Social-Robot/sldprt/ONO-modules/Eye/eye-frame-mbp.SLDPRT

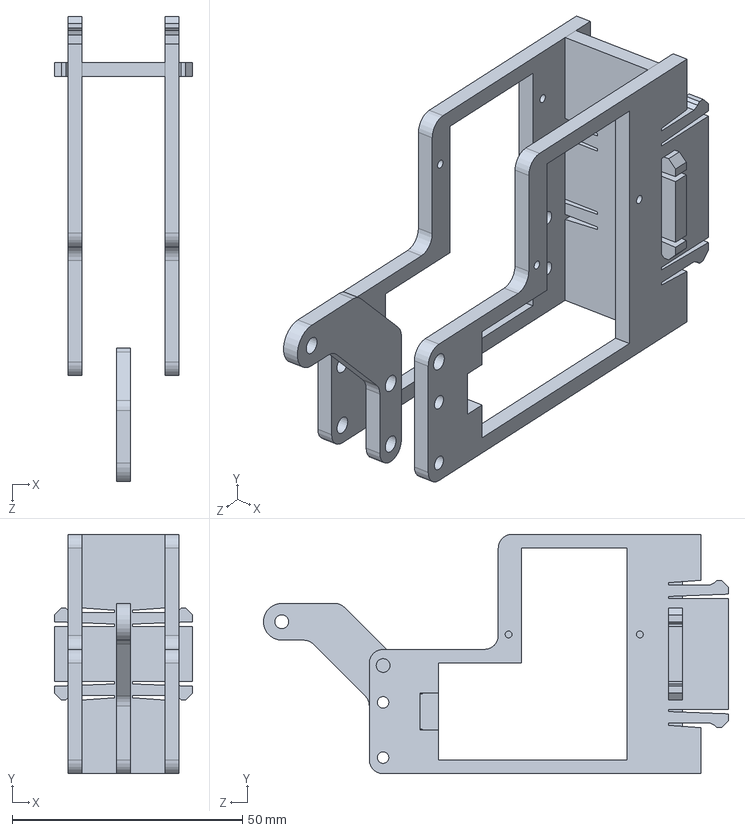
[picture p57: CAD file, 2017-05-16]
sldprt/ONO-modules/Eye/eye-frame-mbp.SLDPRT
30.0 x 52.0 x 101.0 mm
