Bcvdkerc/VOP-Social-Robot/sldprt/ONO-modules/Eyebrow/eyebrow-frame-mbp.SLDPRT

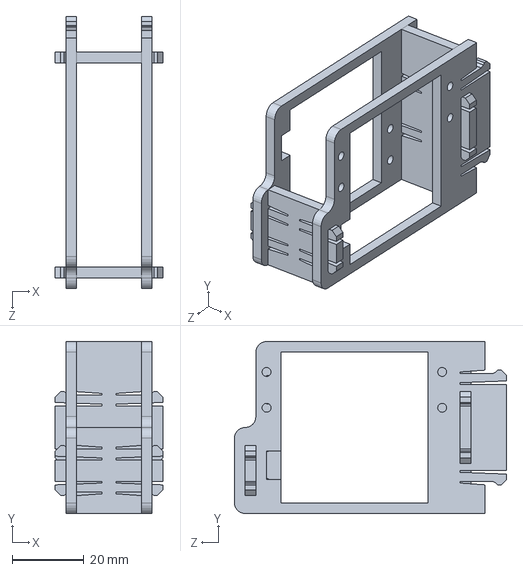
[picture p58: CAD file, 2017-05-16]
sldprt/ONO-modules/Eyebrow/eyebrow-frame-mbp.SLDPRT
30.0 x 48.0 x 76.0 mm
