Bcvdkerc/VOP-Social-Robot/dxf_lasercut/Body/b5.DXF

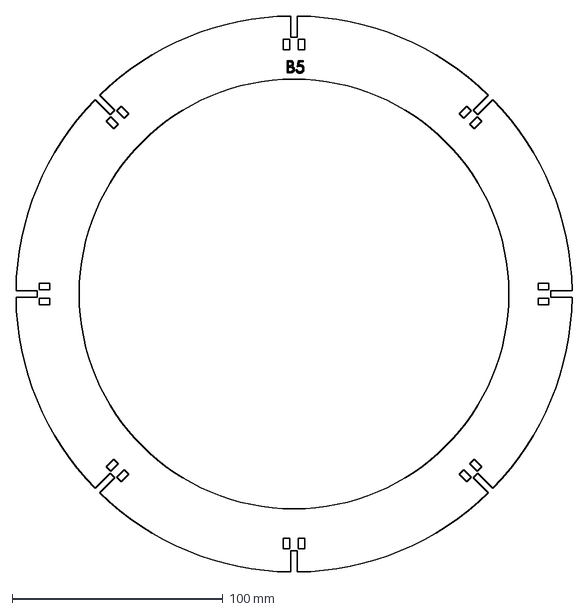
[picture p59: CAD file, 2017-05-16]
dxf_lasercut/Body/b5.DXF
264.0 x 264.0 mm
