Bcvdkerc/VOP-Social-Robot/dxf_lasercut/Head/HY2b.DXF

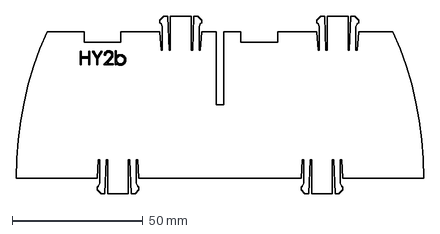
[picture p60: CAD file, 2017-05-16]
dxf_lasercut/Head/HY2b.DXF
155.9 x 68.0 mm
