Bcvdkerc/VOP-Social-Robot/sldprt/Box/BOXY1.SLDPRT

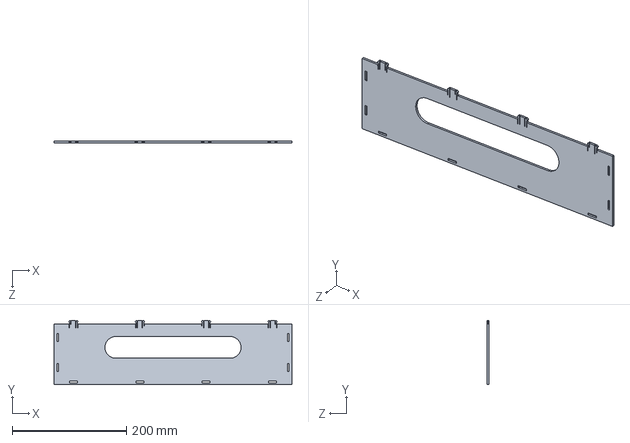
[picture p61: CAD file, 2017-05-16]
sldprt/Box/BOXY1.SLDPRT
416.0 x 112.0 x 3.00 mm
