Bcvdkerc/VOP-Social-Robot/sldprt/Head/HY3a.SLDPRT

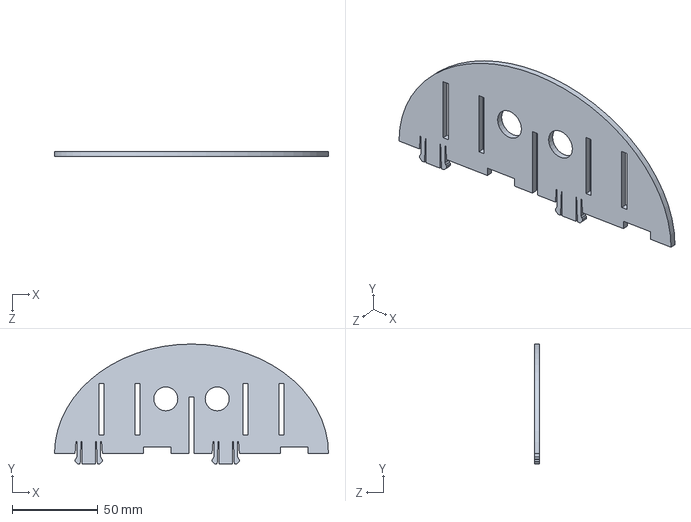
[picture p62: CAD file, 2017-05-16]
sldprt/Head/HY3a.SLDPRT
160.0 x 70.0 x 3.00 mm
