Bcvdkerc/VOP-Social-Robot/sldprt/ONO-modules/Eye/servo-horn-levers-hd.SLDPRT

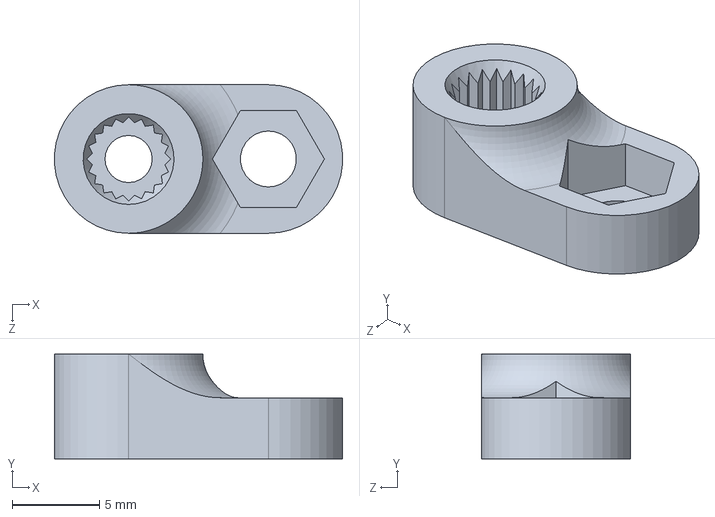
[picture p63: CAD file, 2017-05-16]
sldprt/ONO-modules/Eye/servo-horn-levers-hd.SLDPRT
16.5 x 6.00 x 8.50 mm
