Bcvdkerc/VOP-Social-Robot/sldprt/ONO-modules/Eyebrow/eyebrow-frame-2.sldprt

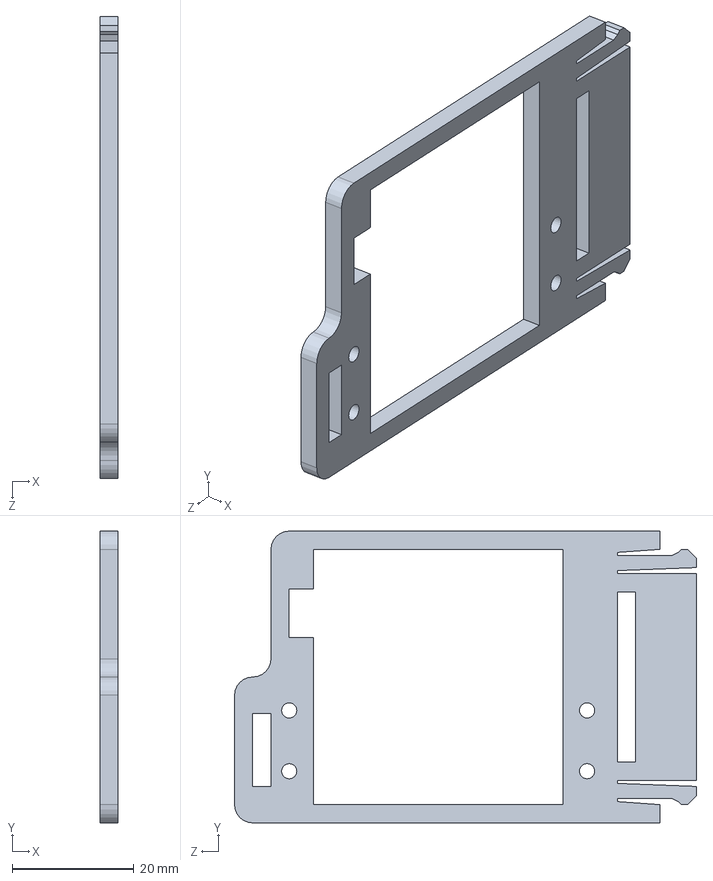
[picture p64: CAD file, 2017-05-16]
sldprt/ONO-modules/Eyebrow/eyebrow-frame-2.sldprt
3.00 x 48.0 x 76.0 mm
