Bcvdkerc/VOP-Social-Robot/sldprt/ONO-modules/Mouth/mouth-frame-1.SLDPRT

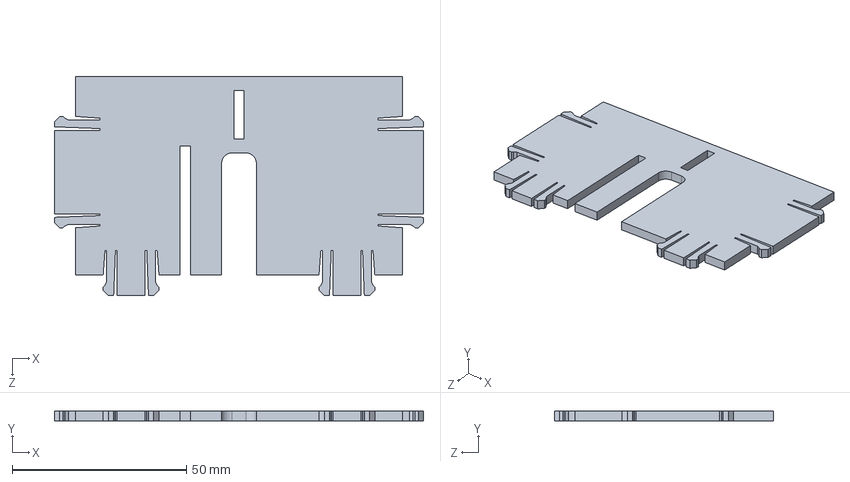
[picture p65: CAD file, 2017-05-16]
sldprt/ONO-modules/Mouth/mouth-frame-1.SLDPRT
106.0 x 3.00 x 63.0 mm
