Bcvdkerc/VOP-Social-Robot/dxf_lasercut/Box/Box_laser.dxf

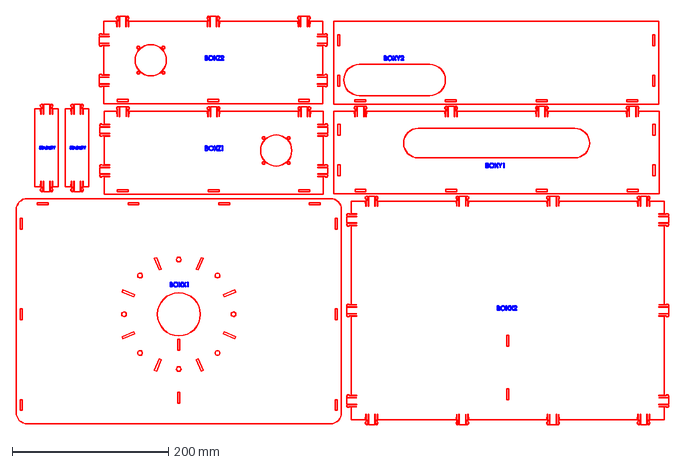
[picture p66: CAD file, 2017-05-16]
dxf_lasercut/Box/Box_laser.dxf
834.8 x 522.1 mm
