Bcvdkerc/VOP-Social-Robot/dxf_lasercut/Head/HY1a.DXF

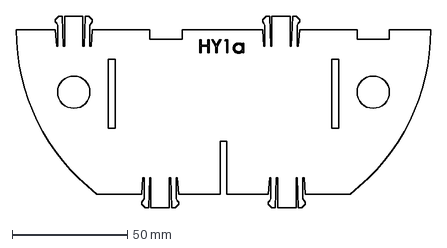
[picture p67: CAD file, 2017-05-16]
dxf_lasercut/Head/HY1a.DXF
180.0 x 83.2 mm
