Bcvdkerc/VOP-Social-Robot/sldprt/Head/HY2b.SLDPRT

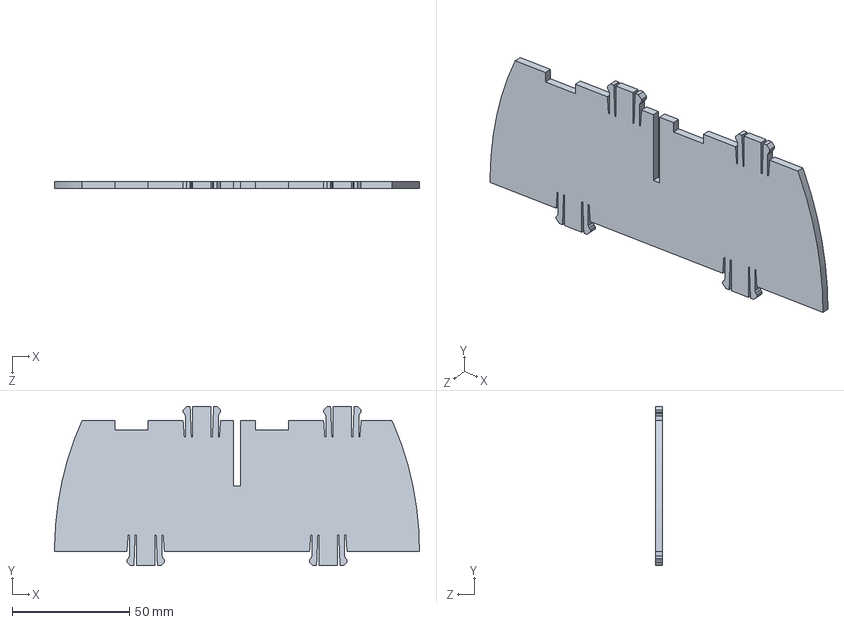
[picture p68: CAD file, 2017-05-16]
sldprt/Head/HY2b.SLDPRT
155.9 x 68.0 x 3.00 mm
