Bcvdkerc/VOP-Social-Robot/sldprt/ONO-modules/Eye/eyelid-spacer.SLDPRT

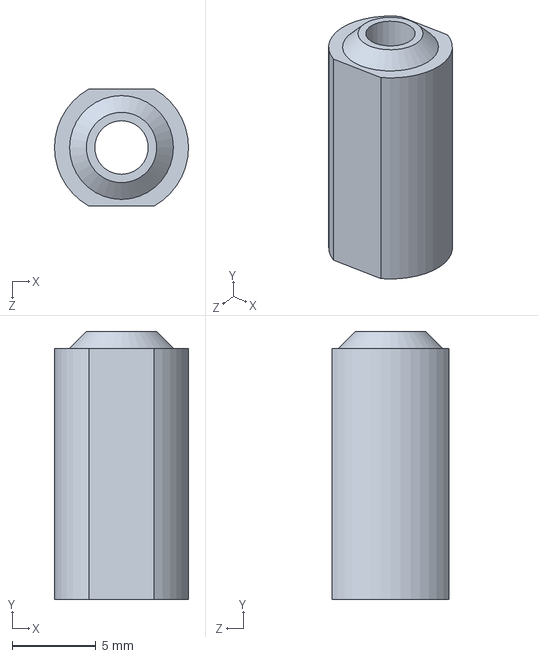
[picture p69: CAD file, 2017-05-16]
sldprt/ONO-modules/Eye/eyelid-spacer.SLDPRT
8.00 x 16.0 x 7.00 mm
