Bcvdkerc/VOP-Social-Robot/3d-printing/eye - balljoint-housing-1.STL

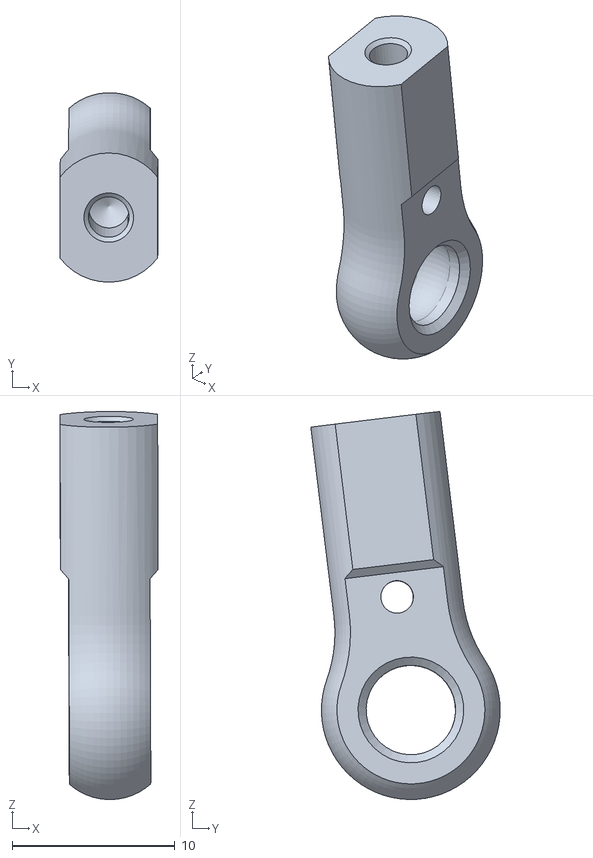
[picture p70: CAD file, 2017-05-16]
3d-printing/eye - balljoint-housing-1.STL
6.05 x 11.6 x 23.8
