Bcvdkerc/VOP-Social-Robot/dxf_lasercut/Head/HY2a.DXF

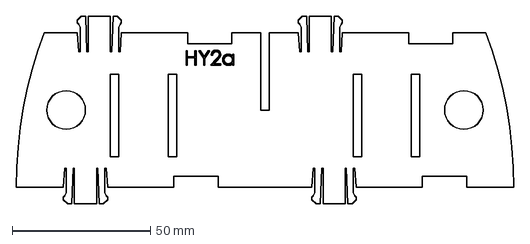
[picture p71: CAD file, 2017-05-16]
dxf_lasercut/Head/HY2a.DXF
180.0 x 68.0 mm
