Bcvdkerc/VOP-Social-Robot/sldprt/ONO-modules/Eye/eye-frame-3.sldprt

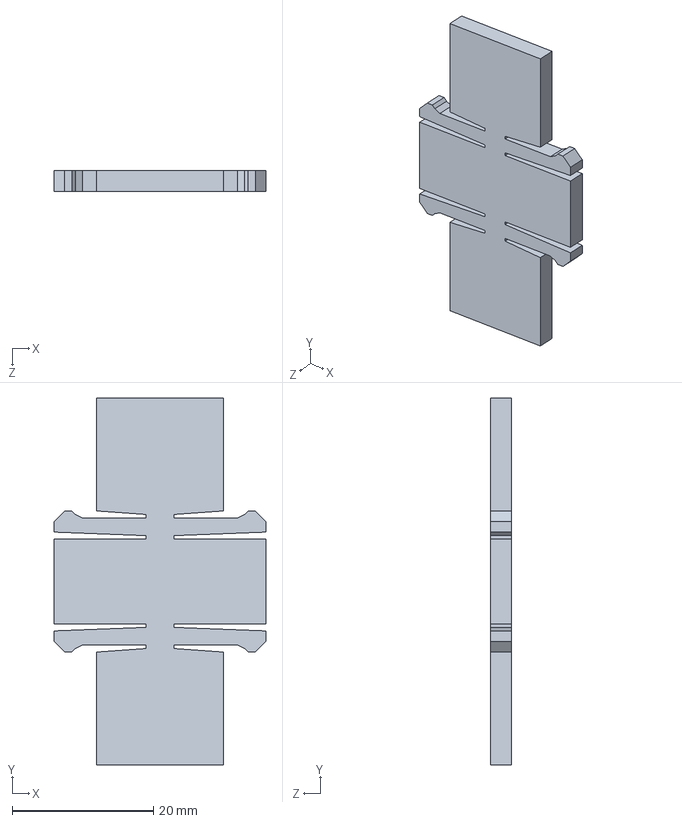
[picture p72: CAD file, 2017-05-16]
sldprt/ONO-modules/Eye/eye-frame-3.sldprt
30.0 x 52.0 x 3.00 mm
