Bcvdkerc/VOP-Social-Robot/sldprt/ONO-modules/Mouth/lever-mid-printed-horn.SLDPRT

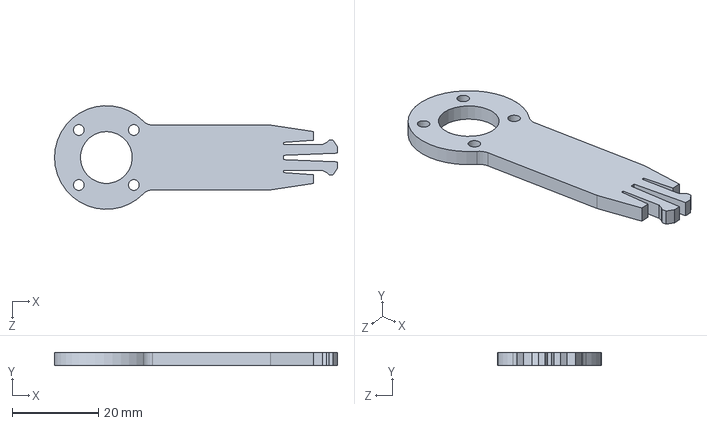
[picture p73: CAD file, 2017-05-16]
sldprt/ONO-modules/Mouth/lever-mid-printed-horn.SLDPRT
65.5 x 3.00 x 24.0 mm
