Bcvdkerc/VOP-Social-Robot/dxf_lasercut/Head/HZ2.DXF

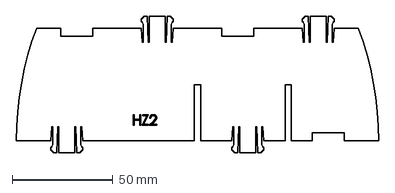
[picture p74: CAD file, 2017-05-16]
dxf_lasercut/Head/HZ2.DXF
180.0 x 68.0 mm
