Bcvdkerc/VOP-Social-Robot/sldprt/ONO-modules/Eyebrow/lever-inner-printed-horn.SLDPRT

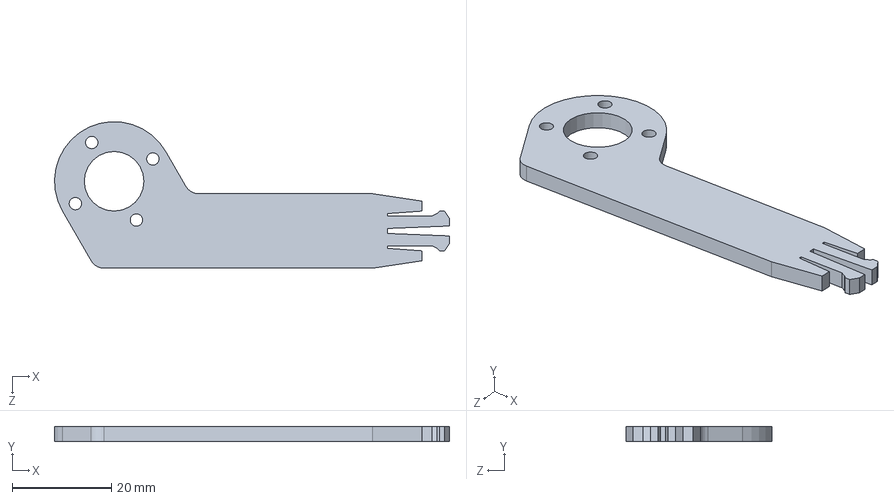
[picture p75: CAD file, 2017-05-16]
sldprt/ONO-modules/Eyebrow/lever-inner-printed-horn.SLDPRT
79.5 x 3.00 x 29.5 mm
