Bcvdkerc/VOP-Social-Robot/3d-printing/eye - lever-horizontal-1.STL

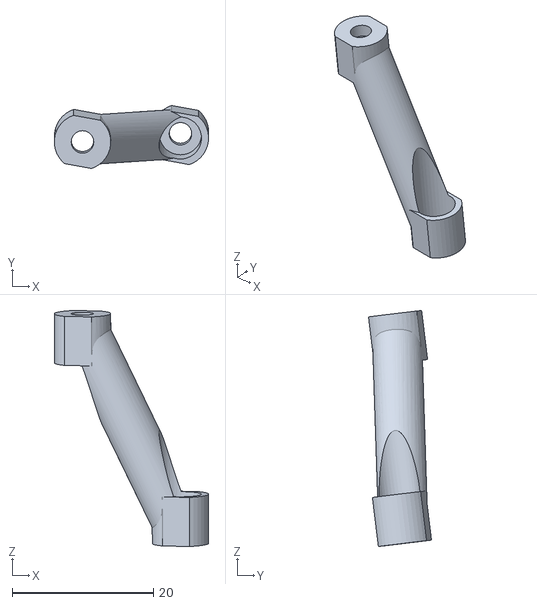
[picture p76: CAD file, 2017-05-16]
3d-printing/eye - lever-horizontal-1.STL
21.9 x 8.93 x 33.4
