Bcvdkerc/VOP-Social-Robot/dxf_lasercut/Head/HZ1.DXF

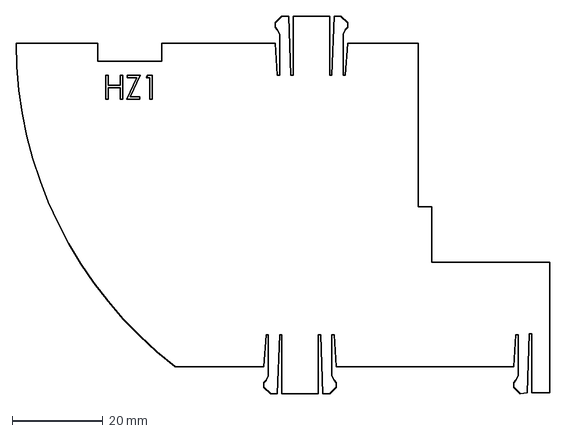
[picture p77: CAD file, 2017-05-16]
dxf_lasercut/Head/HZ1.DXF
117.5 x 83.2 mm
