Bcvdkerc/VOP-Social-Robot/sldprt/Head/HY1a.SLDPRT

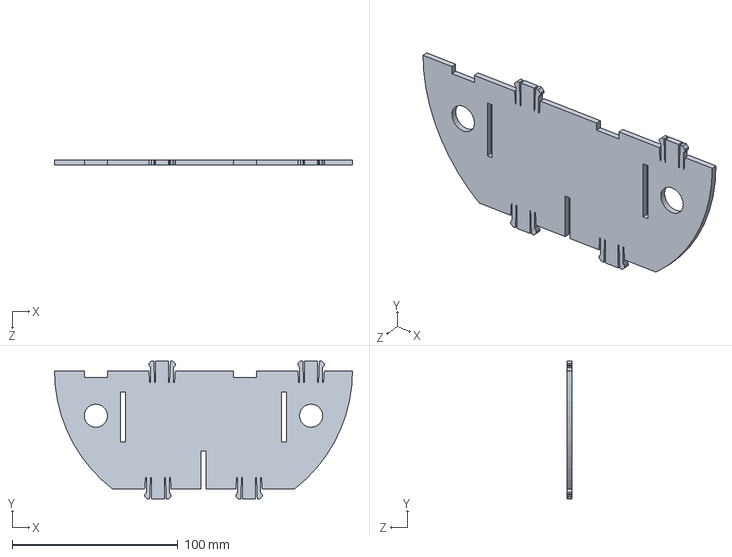
[picture p78: CAD file, 2017-05-16]
sldprt/Head/HY1a.SLDPRT
180.0 x 83.2 x 3.00 mm
