Bcvdkerc/VOP-Social-Robot/sldprt/ONO-modules/Eye/eyelid-lower.SLDPRT

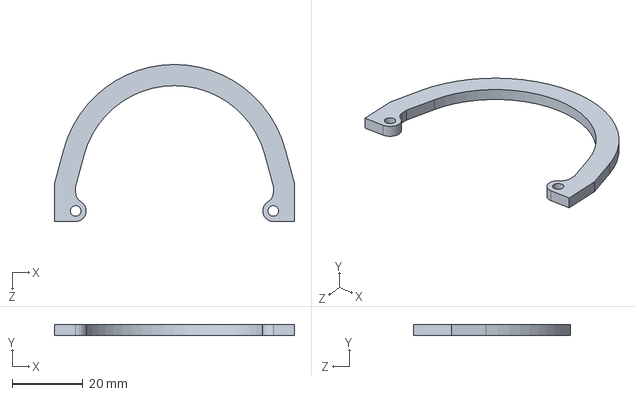
[picture p79: CAD file, 2017-05-16]
sldprt/ONO-modules/Eye/eyelid-lower.SLDPRT
68.0 x 3.00 x 44.5 mm
