Bcvdkerc/VOP-Social-Robot/sldprt/ONO-modules/Mouth/mouth-frame-mbp.SLDPRT

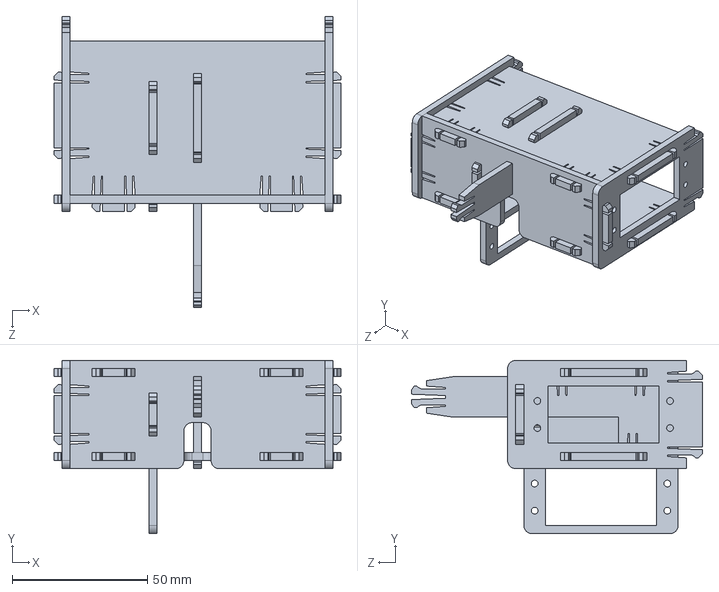
[picture p80: CAD file, 2017-05-16]
sldprt/ONO-modules/Mouth/mouth-frame-mbp.SLDPRT
106.0 x 64.0 x 107.5 mm
