Bcvdkerc/VOP-Social-Robot/3d-printing/eye - balljoint-ball-1.STL

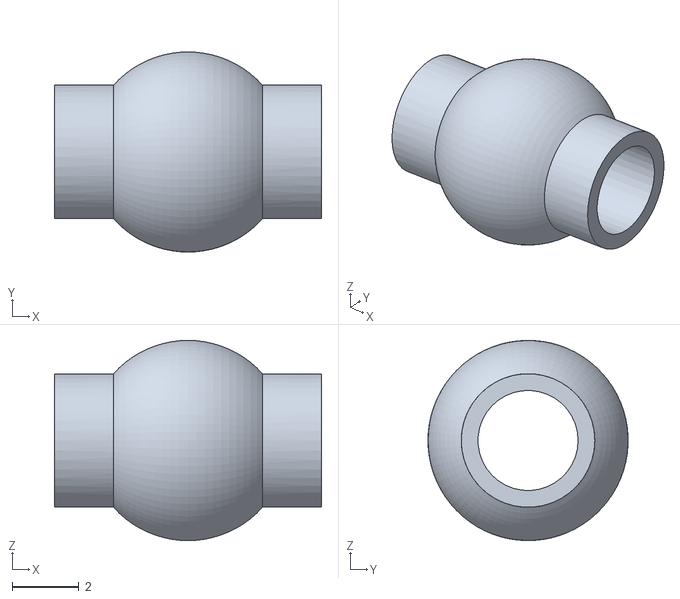
[picture p81: CAD file, 2017-05-16]
3d-printing/eye - balljoint-ball-1.STL
8.00 x 6.00 x 6.00
