Bcvdkerc/VOP-Social-Robot/dxf_lasercut/Head/HX3.DXF

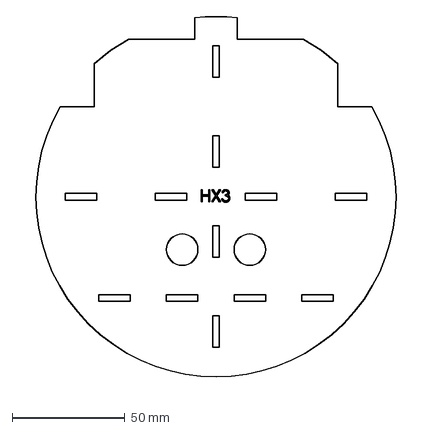
[picture p82: CAD file, 2017-05-16]
dxf_lasercut/Head/HX3.DXF
177.4 x 166.4 mm
