Bcvdkerc/VOP-Social-Robot/sldprt/ONO-modules/Mouth/lever-mid-towerpro-horn.SLDPRT

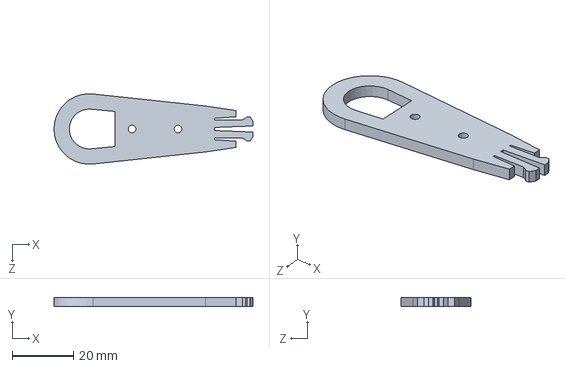
[picture p84: CAD file, 2017-05-16]
sldprt/ONO-modules/Mouth/lever-mid-towerpro-horn.SLDPRT
65.0 x 3.00 x 23.0 mm
