Bcvdkerc/VOP-Social-Robot/3d-printing/eye - lever-vertical-1.STL

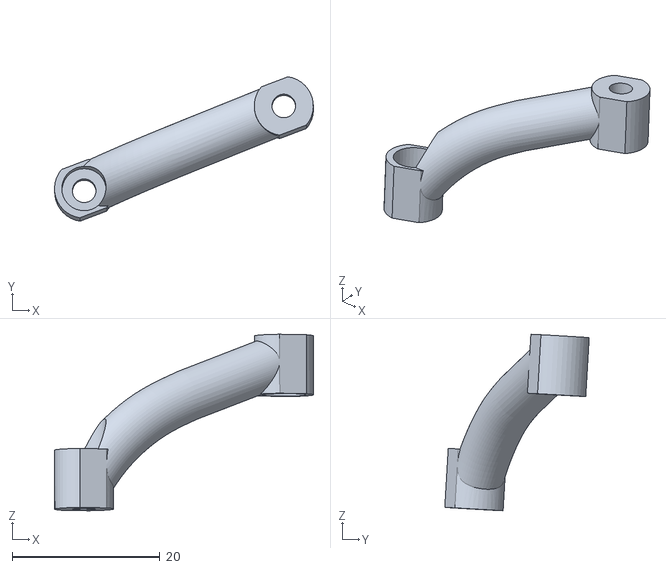
[picture p85: CAD file, 2017-05-16]
3d-printing/eye - lever-vertical-1.STL
35.1 x 19.6 x 23.9
