Bcvdkerc/VOP-Social-Robot/sldprt/ONO-modules/Eye/eyelid-servo-gear-lasered-a.SLDPRT

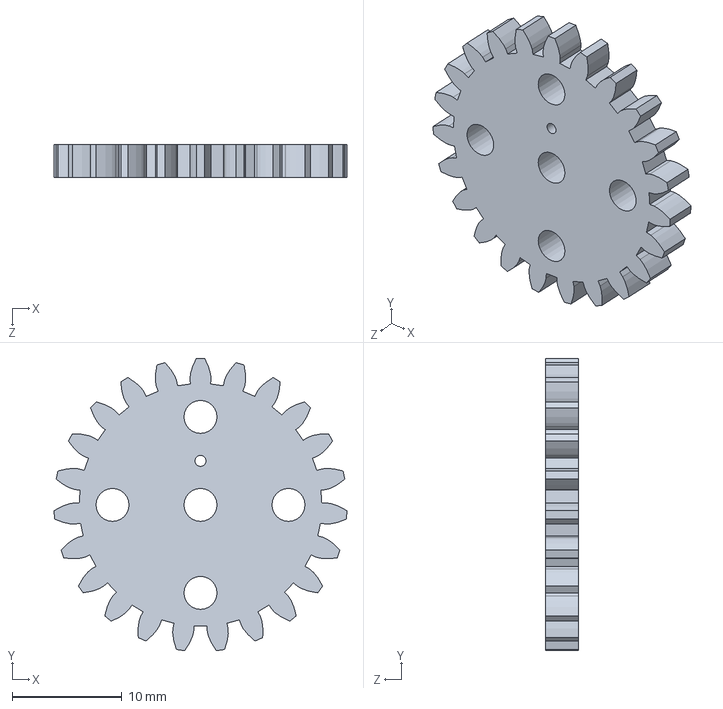
[picture p86: CAD file, 2017-05-16]
sldprt/ONO-modules/Eye/eyelid-servo-gear-lasered-a.SLDPRT
26.6 x 26.6 x 3.00 mm
