Bcvdkerc/VOP-Social-Robot/sldprt/ONO-modules/Eye/eyelid-servo-gear-printed.SLDPRT

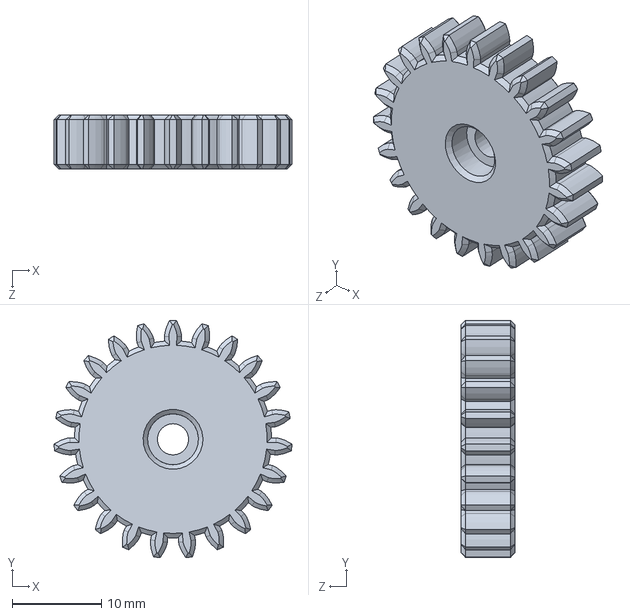
[picture p87: CAD file, 2017-05-16]
sldprt/ONO-modules/Eye/eyelid-servo-gear-printed.SLDPRT
26.6 x 26.6 x 6.00 mm
