Bcvdkerc/VOP-Social-Robot/sldprt/ONO-modules/Eye/eye-frame-4.sldprt

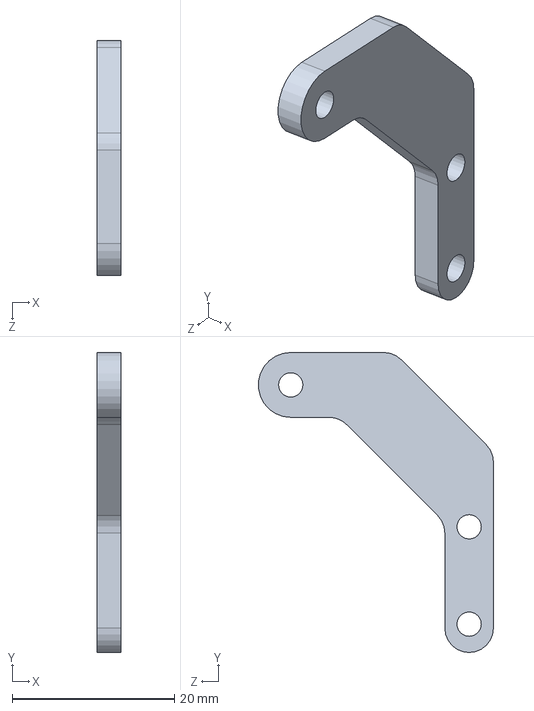
[picture p88: CAD file, 2017-05-16]
sldprt/ONO-modules/Eye/eye-frame-4.sldprt
3.00 x 37.0 x 29.0 mm
