Bcvdkerc/VOP-Social-Robot/sldprt/ONO-modules/Eye/eye-frame-1.sldprt

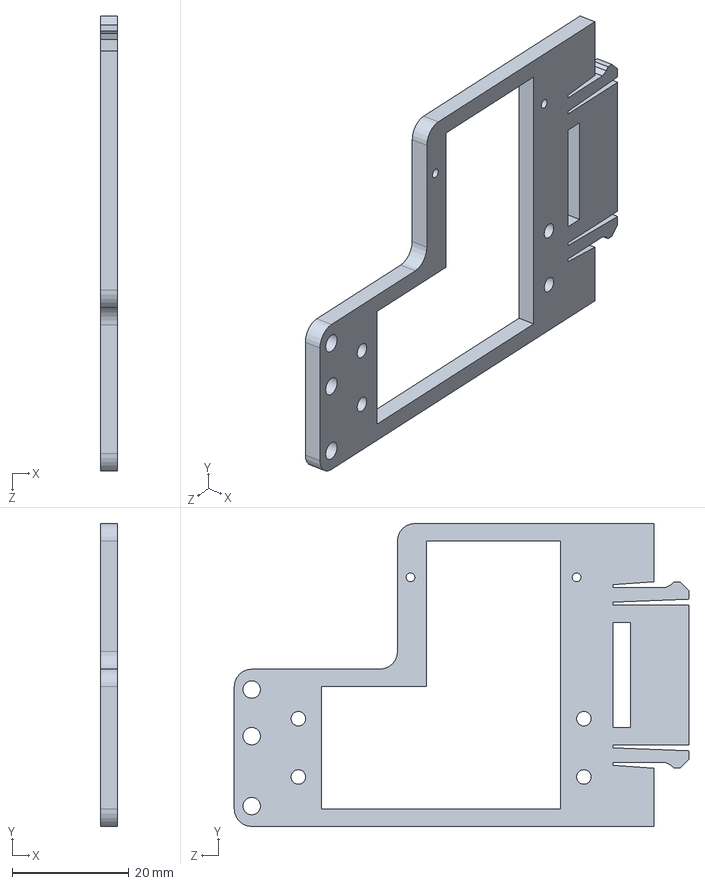
[picture p89: CAD file, 2017-05-16]
sldprt/ONO-modules/Eye/eye-frame-1.sldprt
3.00 x 52.0 x 78.0 mm
