Bcvdkerc/VOP-Social-Robot/sldprt/ONO-modules/Eye/lever-vertical.SLDPRT

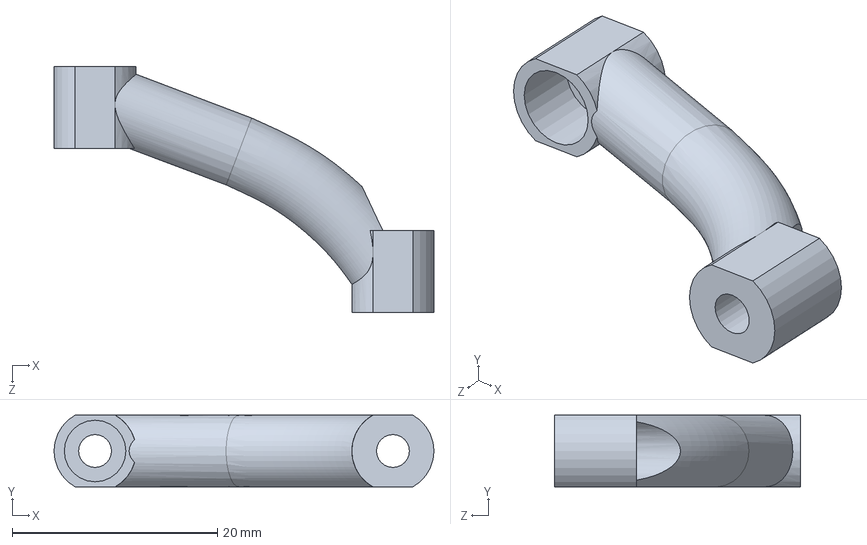
[picture p90: CAD file, 2017-05-16]
sldprt/ONO-modules/Eye/lever-vertical.SLDPRT
37.0 x 7.00 x 24.0 mm
