Bcvdkerc/VOP-Social-Robot/sldprt/ONO-modules/Eye/pivot-beam-r.SLDPRT

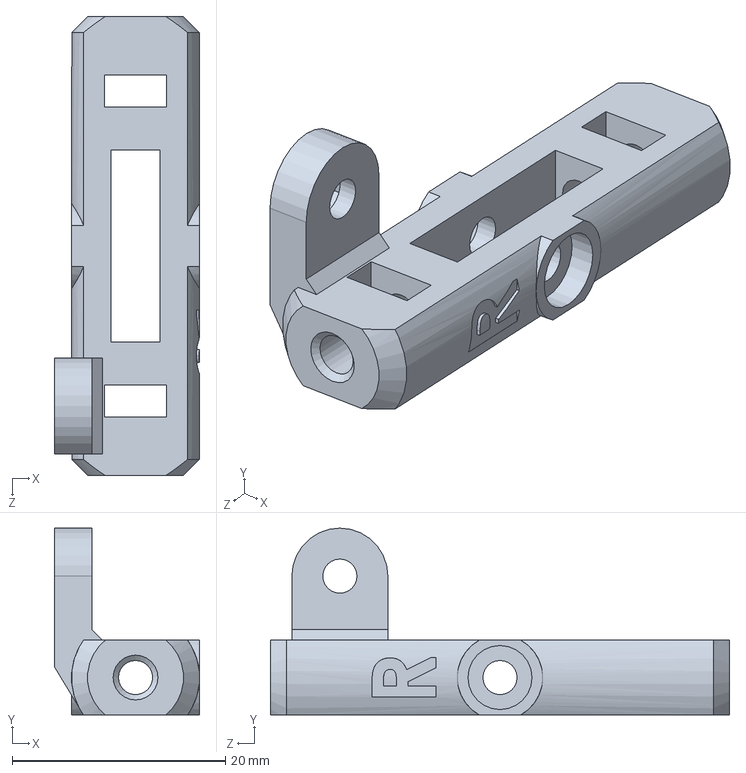
[picture p91: CAD file, 2017-05-16]
sldprt/ONO-modules/Eye/pivot-beam-r.SLDPRT
13.6 x 17.5 x 43.0 mm
