Bcvdkerc/VOP-Social-Robot/sldprt/ONO-modules/Eye/lever-horizontal.SLDPRT

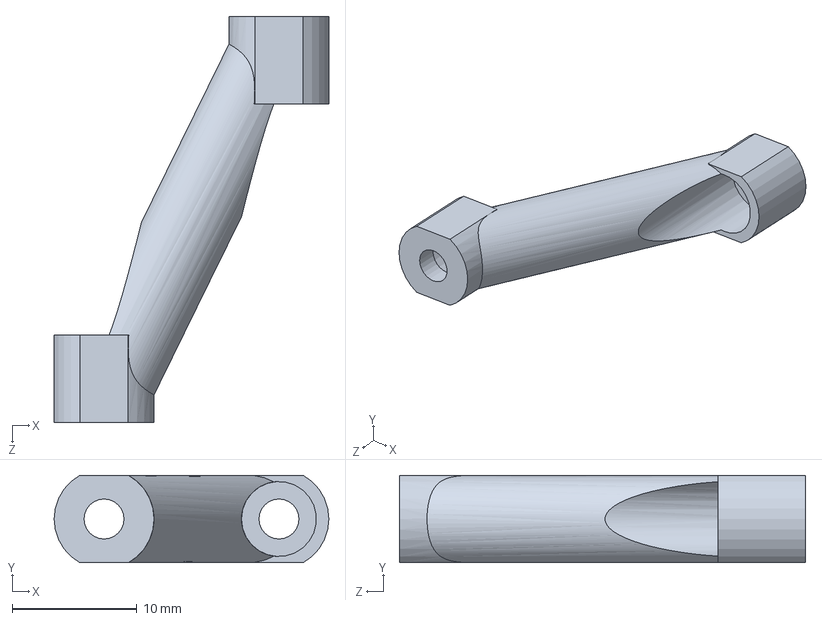
[picture p92: CAD file, 2017-05-16]
sldprt/ONO-modules/Eye/lever-horizontal.SLDPRT
22.0 x 7.00 x 32.5 mm
