Bcvdkerc/VOP-Social-Robot/sldprt/ONO-modules/Eye/iris.SLDPRT

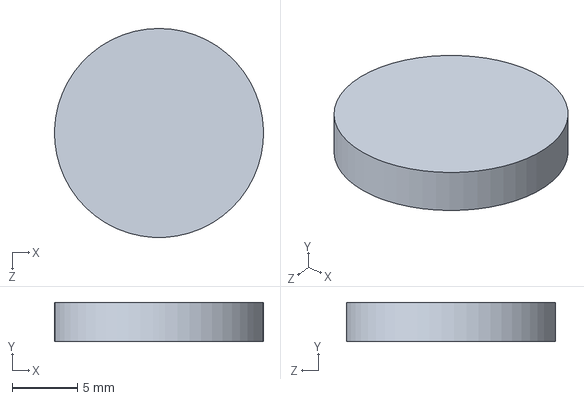
[picture p94: CAD file, 2017-05-16]
sldprt/ONO-modules/Eye/iris.SLDPRT
16.0 x 3.00 x 16.0 mm
