Bcvdkerc/VOP-Social-Robot/(list of files, cad)

Other CAD files:
sldprt/Neck/neck.SLDPRT
sldprt/ONO-modules/Mouth/mouth-frame-5.sldprt
3d-printing/pivot-beam-l.STL
dxf_lasercut/Box/stability.DXF
dxf_lasercut/Box/BOXX2.DXF
sldprt/Box/BOXZ2.SLDPRT
sldprt/ONO-modules/Eye/eye-shell.SLDPRT
dxf_lasercut/Box/BOXY2.DXF
sldprt/ONO-modules/Eye/eyelid-idler-r.SLDPRT
sldprt/ONO-modules/Mouth/mouth-frame-2.sldprt
sldprt/ONO-modules/Eye/eyelid-idler.SLDPRT
3d-printing/eye-shell-r.STL
dxf_lasercut/Box/BOXX1.DXF
sldprt/Body/b4.SLDPRT
sldprt/ONO-modules/Mouth/mouth-frame-6.sldprt
3d-printing/eyelid-idler-l.STL
dxf_lasercut/Box/BOXY1.DXF
3d-printing/eyelid-gear-r.STL
sldprt/ONO-modules/Eyebrow/eyebrow-frame-1.sldprt
sldprt/ONO-modules/Mouth/lever-outer-l-towerpro-horn.SLDPRT
sldprt/Head/HY2a.SLDPRT
3d-printing/eye - eye-frame-spacer-1-1.STL
sldprt/Head/HZ3.SLDPRT
sldprt/ONO-modules/Eye/eye-shell-l.SLDPRT
sldprt/ONO-modules/Mouth/lever-outer-r-printed-horn.SLDPRT
sldprt/ONO-modules/Eye/eyelid-idler-l.SLDPRT
sldprt/ONO-modules/Mouth/mouth-frame-3.sldprt
3d-printing/eye - eyelid-spacer-1.STL
sldprt/ONO-modules/Mouth/mouth-frame-7.sldprt
sldprt/ONO-modules/Eye/eyelid-gear.SLDPRT
sldprt/ONO-modules/Mouth/mouth-frame-4.sldprt
sldprt/ONO-modules/Eye/eye-shell-r.SLDPRT
sldprt/ONO-modules/Eye/eyelid-gear-r.SLDPRT
sldprt/ONO-modules/Eye/eyelid-servo-gear-lasered-b.SLDPRT
sldprt/ONO-modules/Eye/pivot-beam.SLDPRT
sldprt/ONO-modules/Eye/eyelid-gear-l.SLDPRT
sldprt/ONO-modules/Eye/pivot-beam-l.SLDPRT
sldprt/ONO-modules/Eye/eye-laser.SLDDRW
sldprt/ONO-modules/Eye/eyelid-gears.3dm
sldprt/ONO-modules/Eyebrow/eyebrow-laser.SLDDRW
sldprt/ONO-modules/Mouth/mouth-laser.SLDDRW
