Bcvdkerc/VOP-Social-Robot/3d-printing/readme.rtf

Eye-shellL: 1x WIT
Eye-shellR: 1x WIT
Pivot-beamL: 1x
Pivot-beamR: 1x
balljoint-ball: 8x
balljoint-housing: 8x
eye-frame-spacer: 4x
lever-horizontal: 2x
lever-vertical: 2x
eyelid-spacer: 4x
eyelid-gearL: 1x
eyelid-gearR: 1x
eyelid-idlerL: 1x
eyelid-idlerR: 1x
