Bcvdkerc/VOP-Social-Robot/(commit log)

2017-05-16 Create servo information
2017-05-17 Update servo information
